Board-Folk/PC-Engine-Duo/cd_rom_control.kicad_sch

## KiCad design cd_rom_control.kicad_sch (2023-11-11)

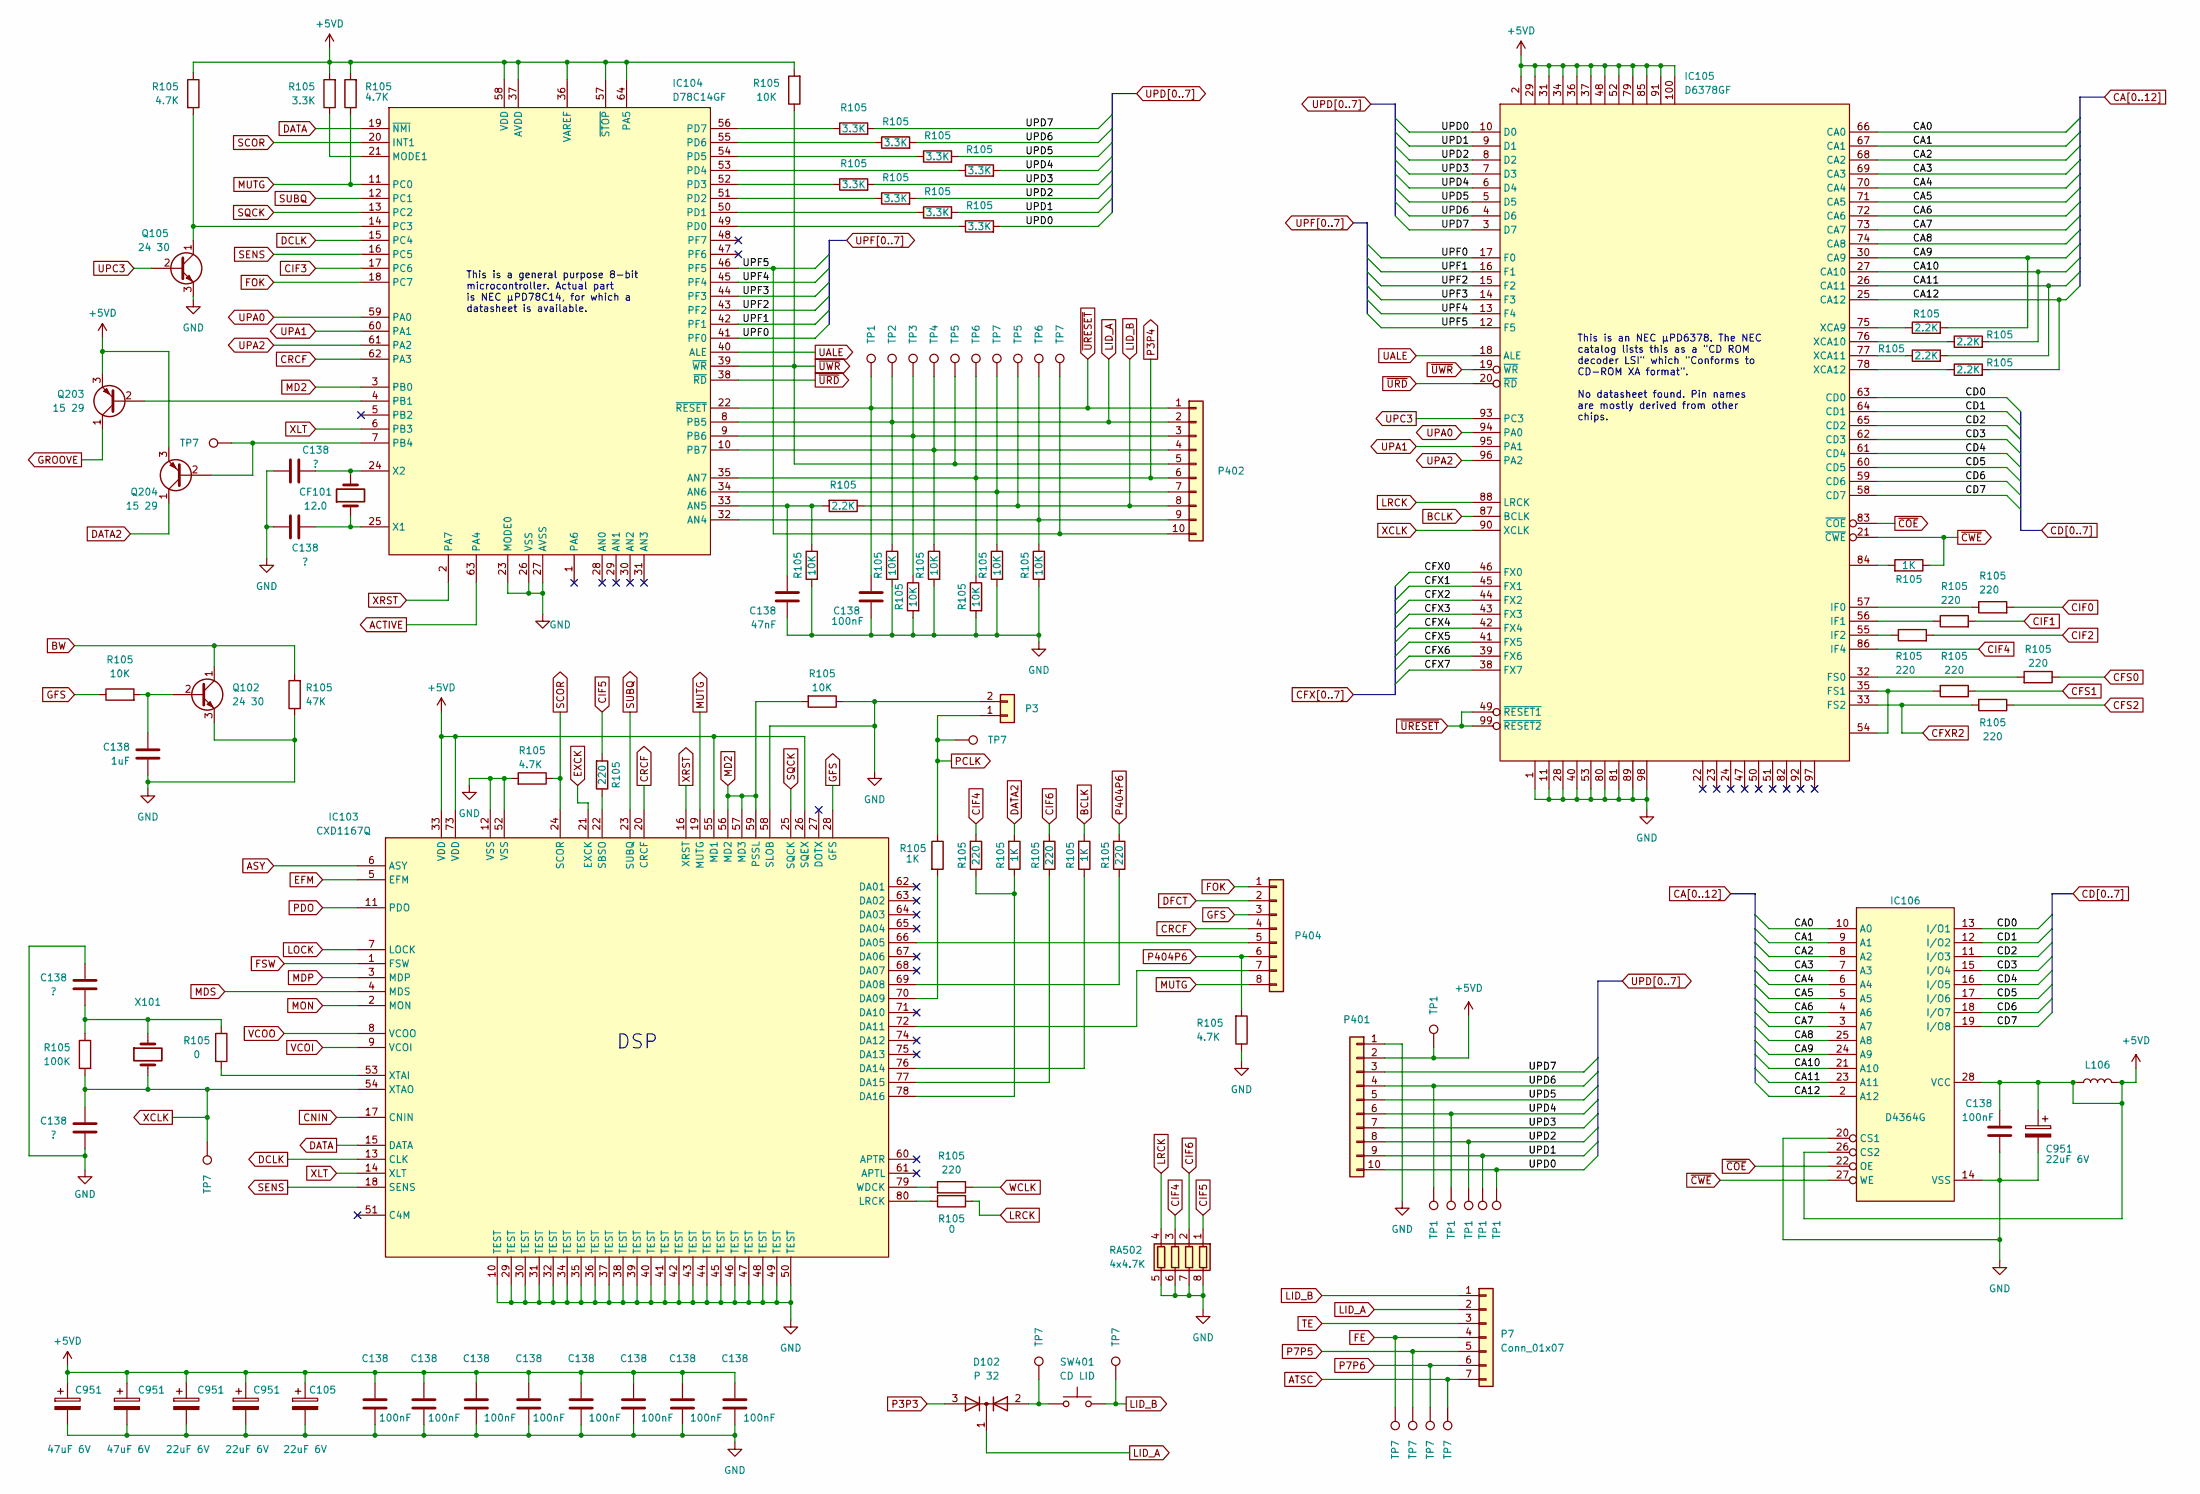
[picture p1: schematic cd_rom_control.kicad_sch]

Parts:
C105, C951: 22uF 6V; CP_6x1.5mm
C138: 100nF; SMD_0805_Narrow_Long
CF101: 12.0; CF_4.4x7.8
D102: P 32; Transistor_SMD
IC103: CXD1167Q; PQFP-80_P0.8mm
IC104: D78C14GF; QFP-64_19x13_Pitch1mm
IC105: D6378GF; PQFP-100_P0.65mm
IC106: D4364G; HSRM20256LM
L106: SMD_0805_Narrow
P3: Header_1x02_P2.00mm
P7: Conn_01x07; Header_1x07_P2.00mm
P401, P402: Header_1x10_P2.00mm
P404: Header_1x08_P2.00mm_Narrow
Q102, Q105: 24 30; Transistor_SMD
Q203, Q204: 15 29; Transistor_SMD
R105: 2.2K; SMD_0805_Narrow_Long
RA502: 4x4.7K; R_Array_4x0603
SW401: CD LID; SW_4Pin_3.25mm
TP1, TP2, TP3, TP4, TP5, TP6, TP7: Test_Point_1.5mm
X101: Crystal; L-5.00mm

Connections:
+5VD: C105.1, C138.1, C138.2, C951.1, IC103.26 (SQEX), IC103.33 (VDD), IC103.55 (MD1), IC103.73 (VDD), IC104.36 (VAREF), IC104.37 (AVDD), IC104.57 (~STOP), IC104.58 (VDD), IC104.64 (PA5), IC105.2, IC105.29, IC105.31, IC105.34, IC105.36, IC105.37, IC105.48, IC105.52, IC105.79, IC105.85, IC105.91, IC105.100, IC106.26 (CS2), IC106.28 (VCC), L106.1, L106.2, P401.2, Q203.3 (E), Q204.3 (E), R105.1, R105.2, TP1.1
ACTIVE: IC104.63 (PA4)
ASY: IC103.6 (ASY)
ATSC: P7.7, TP7.1
BCLK: IC105.87 (BCLK), R105.2
BW: Q102.1 (C), R105.2
CA0: IC105.66 (CA0), IC106.10 (A0)
CA1: IC105.67 (CA1), IC106.9 (A1)
CA2: IC105.68 (CA2), IC106.8 (A2)
CA3: IC105.69 (CA3), IC106.7 (A3)
CA4: IC105.70 (CA4), IC106.6 (A4)
CA5: IC105.71 (CA5), IC106.5 (A5)
CA6: IC105.72 (CA6), IC106.4 (A6)
CA7: IC105.73 (CA7), IC106.3 (A7)
CA8: IC105.74 (CA8), IC106.25 (A8)
CA9: IC105.30 (CA9), IC106.24 (A9), R105.2
CA10: IC105.27 (CA10), IC106.21 (A10), R105.2
CA11: IC105.26 (CA11), IC106.23 (A11), R105.2
CA12: IC105.25 (CA12), IC106.2 (A12), R105.2
CD0: IC105.63 (CD0), IC106.13 (I/O1)
CD1: IC105.64 (CD1), IC106.12 (I/O2)
CD2: IC105.65 (CD2), IC106.11 (I/O3)
CD3: IC105.62 (CD3), IC106.15 (I/O4)
CD4: IC105.61 (CD4), IC106.16 (I/O5)
CD5: IC105.60 (CD5), IC106.17 (I/O6)
CD6: IC105.59 (CD6), IC106.18 (I/O7)
CD7: IC105.58 (CD7), IC106.19 (I/O8)
CFS0: R105.1
CFS1: R105.1
CFS2: R105.1
CFX0: IC105.46 (FX0)
CFX1: IC105.45 (FX1)
CFX2: IC105.44 (FX2)
CFX3: IC105.43 (FX3)
CFX4: IC105.42 (FX4)
CFX5: IC105.41 (FX5)
CFX6: IC105.39 (FX6)
CFX7: IC105.38 (FX7)
CFXR2: IC105.33 (FS2), R105.2
CIF0: R105.2
CIF1: R105.2
CIF2: R105.2
CIF3: IC104.17 (PC6)
CIF4: IC105.86 (IF4), R105.2, RA502.3 (R3.1)
CIF5: R105.2, RA502.1 (R1.1)
CIF6: R105.2, RA502.2 (R2.1)
CNIN: IC103.17 (CNIN)
CRCF: IC103.20 (CRCF), IC104.62 (PA3), P404.4
DATA: IC103.15 (DATA), IC104.19 (~NMI)
DATA2: Q204.1 (C), R105.2
DCLK: IC103.13 (CLK), IC104.15 (PC4)
DFCT: P404.2
EFM: IC103.5 (EFM)
EXCK: IC103.21 (EXCK)
FE: P7.4, TP7.1
FOK: IC104.18 (PC7), P404.1
FSW: IC103.1 (FSW)
GFS: IC103.28 (GFS), P404.3, R105.1
GND: C105.2, C138.1, C138.2, C951.2, IC103.10 (TEST), IC103.12 (VSS), IC103.29 (TEST), IC103.30 (TEST), IC103.31 (TEST), IC103.32 (TEST), IC103.34 (TEST), IC103.35 (TEST), IC103.36 (TEST), IC103.37 (TEST), IC103.38 (TEST), IC103.39 (TEST), IC103.40 (TEST), IC103.41 (TEST), IC103.42 (TEST), IC103.43 (TEST), IC103.44 (TEST), IC103.45 (TEST), IC103.46 (TEST), IC103.47 (TEST), IC103.48 (TEST), IC103.49 (TEST), IC103.50 (TEST), IC103.52 (VSS), IC103.58 (SLOB), IC104.23 (MODE0), IC104.26 (VSS), IC104.27 (AVSS), IC105.1, IC105.11, IC105.28, IC105.40, IC105.53, IC105.80, IC105.81, IC105.89, IC105.98, IC106.14 (VSS), IC106.20 (CS1), P3.2, P401.1, Q102.3 (E), Q105.3 (E), R105.1, R105.2, RA502.5 (R4.2), RA502.6 (R3.2), RA502.7 (R2.2), RA502.8 (R1.2)
GROOVE: Q203.1 (C)
LID_A: D102.1 (K), IC104.8 (PB5), P7.2, P402.2, R105.1, TP2.1
LID_B: P7.1, P402.8, R105.1, SW401.2, TP5.1, TP7.1
LOCK: IC103.7 (LOCK)
LRCK: IC105.88 (LRCK), R105.2, RA502.4 (R4.1)
MD2: IC103.56 (MD2), IC103.57 (MD3), IC103.59 (PSSL), IC104.3 (PB0), R105.2
MDP: IC103.3 (MDP)
MDS: IC103.4 (MDS)
MON: IC103.2 (MON)
MUTG: IC103.19 (MUTG), IC104.11 (PC0), P404.8, R105.1
unnamed: C138.1, CF101.1, CF101.2, IC104.24 (X2), IC104.25 (X1), Q102.2 (B), R105.2
unnamed: C138.2, IC104.33 (AN5), R105.1, R105.2, X101.1
unnamed: D102.2 (A), SW401.1, TP7.1
unnamed: IC103.22 (SBSO), R105.1
unnamed: IC103.53 (XTAI), R105.2
unnamed: IC103.66 (DA05), P404.5
unnamed: IC103.69 (DA08), R105.1
unnamed: IC103.70 (DA09), R105.2
unnamed: IC103.72 (DA11), P404.7
unnamed: IC103.76 (DA14), R105.1
unnamed: IC103.77 (DA15), R105.1
unnamed: IC103.78 (DA16), R105.1
unnamed: IC103.79 (WDCK), R105.2
unnamed: IC103.80 (LRCK), R105.1
unnamed: IC104.4 (PB1), Q203.2 (B)
unnamed: IC104.7 (PB4), Q204.2 (B), TP7.1
unnamed: IC104.9 (PB6), P402.3, R105.1, TP3.1
unnamed: IC104.10 (PB7), P402.4, R105.1, TP4.1
unnamed: IC104.14 (PC3), Q105.1 (C), R105.2
unnamed: IC104.21 (MODE1), R105.1
unnamed: IC104.32 (AN4), P402.9, R105.1, TP6.1
unnamed: IC104.34 (AN6), P402.7, R105.1, TP7.1
unnamed: IC104.49 (PD0), R105.1
unnamed: IC104.50 (PD1), R105.1
unnamed: IC104.51 (PD2), R105.1
unnamed: IC104.52 (PD3), R105.1
unnamed: IC104.53 (PD4), R105.1
unnamed: IC104.54 (PD5), R105.1
unnamed: IC104.55 (PD6), R105.1
unnamed: IC104.56 (PD7), R105.1
unnamed: IC105.32 (FS0), R105.2
unnamed: IC105.35 (FS1), IC105.54, R105.2
unnamed: IC105.55 (IF2), R105.1
unnamed: IC105.56 (IF1), R105.1
unnamed: IC105.57 (IF0), R105.1
unnamed: IC105.75 (XCA9), R105.1
unnamed: IC105.76 (XCA10), R105.1
unnamed: IC105.77 (XCA11), R105.1
unnamed: IC105.78 (XCA12), R105.1
unnamed: IC105.84, R105.2
P3P3: D102.3 (A)
P3P4: IC104.35 (AN7), P402.6, R105.1, TP6.1
P7P5: P7.5, TP7.1
P7P6: P7.6, TP7.1
P404P6: P404.6, R105.2
PCLK: P3.1, R105.1, TP7.1
PDO: IC103.11 (PDO)
SCOR: IC103.24 (SCOR), IC104.20 (INT1), R105.1
SENS: IC103.18 (SENS), IC104.16 (PC5)
SQCK: IC103.25 (SQCK), IC104.13 (PC2)
SUBQ: IC103.23 (SUBQ), IC104.12 (PC1)
TE: P7.3
UALE: IC104.40 (ALE), IC105.18 (ALE)
UPA0: IC104.59 (PA0), IC105.94 (PA0)
UPA1: IC104.60 (PA1), IC105.95 (PA1)
UPA2: IC104.61 (PA2), IC105.96 (PA2)
UPC3: IC105.93 (PC3), Q105.2 (B)
UPD0: IC105.10 (D0), P401.10, R105.2, TP1.1
UPD1: IC105.9 (D1), P401.9, R105.2, TP1.1
UPD2: IC105.8 (D2), P401.8, R105.2, TP1.1
UPD3: IC105.7 (D3), P401.7, R105.2
UPD4: IC105.6 (D4), P401.6, R105.2, TP1.1
UPD5: IC105.5 (D5), P401.5, R105.2
UPD6: IC105.4 (D6), P401.4, R105.2, TP1.1
UPD7: IC105.3 (D7), P401.3, R105.2
UPF0: IC104.41 (PF0), IC105.17 (F0)
UPF1: IC104.42 (PF1), IC105.16 (F1)
UPF2: IC104.43 (PF2), IC105.15 (F2)
UPF3: IC104.44 (PF3), IC105.14 (F3)
UPF4: IC104.45 (PF4), IC105.13 (F4)
UPF5: IC104.46 (PF5), IC105.12 (F5), P402.10, TP7.1
VCOI: IC103.9 (VCOI)
VCOO: IC103.8 (VCOO)
WCLK: R105.1
XCLK: C138.2, IC103.54 (XTAO), IC105.90 (XCLK), R105.2, TP7.1, X101.2
XLT: IC103.14 (XLT), IC104.6 (PB3)
XRST: IC103.16 (XRST), IC104.2 (PA7)
~COE: IC105.83 (~COE), IC106.22 (OE)
~CWE: IC105.21 (~CWE), IC106.27 (WE), R105.1
~URD: IC104.38 (~RD), IC105.20 (~RD)
~URESET: C138.1, IC104.22 (~RESET), IC105.49 (~RESET1), IC105.99 (~RESET2), P402.1, TP1.1
~UWR: IC104.39 (~WR), IC105.19 (~WR), P402.5, R105.1, TP5.1

Notes on the sheet:
This is an NEC μPD6378. The NEC catalog lists this as a "CD ROM decoder LSI" which "Conforms to CD-ROM XA format". No datasheet found. Pin names are mostly derived from other chips.
This is a general purpose 8-bit microcontroller. Actual part is NEC μPD78C14, for which a datasheet is available.
DSP
