Board-Folk/PC-Engine-Duo/cd_rom_mech.kicad_sch

## KiCad design cd_rom_mech.kicad_sch (2023-11-13)

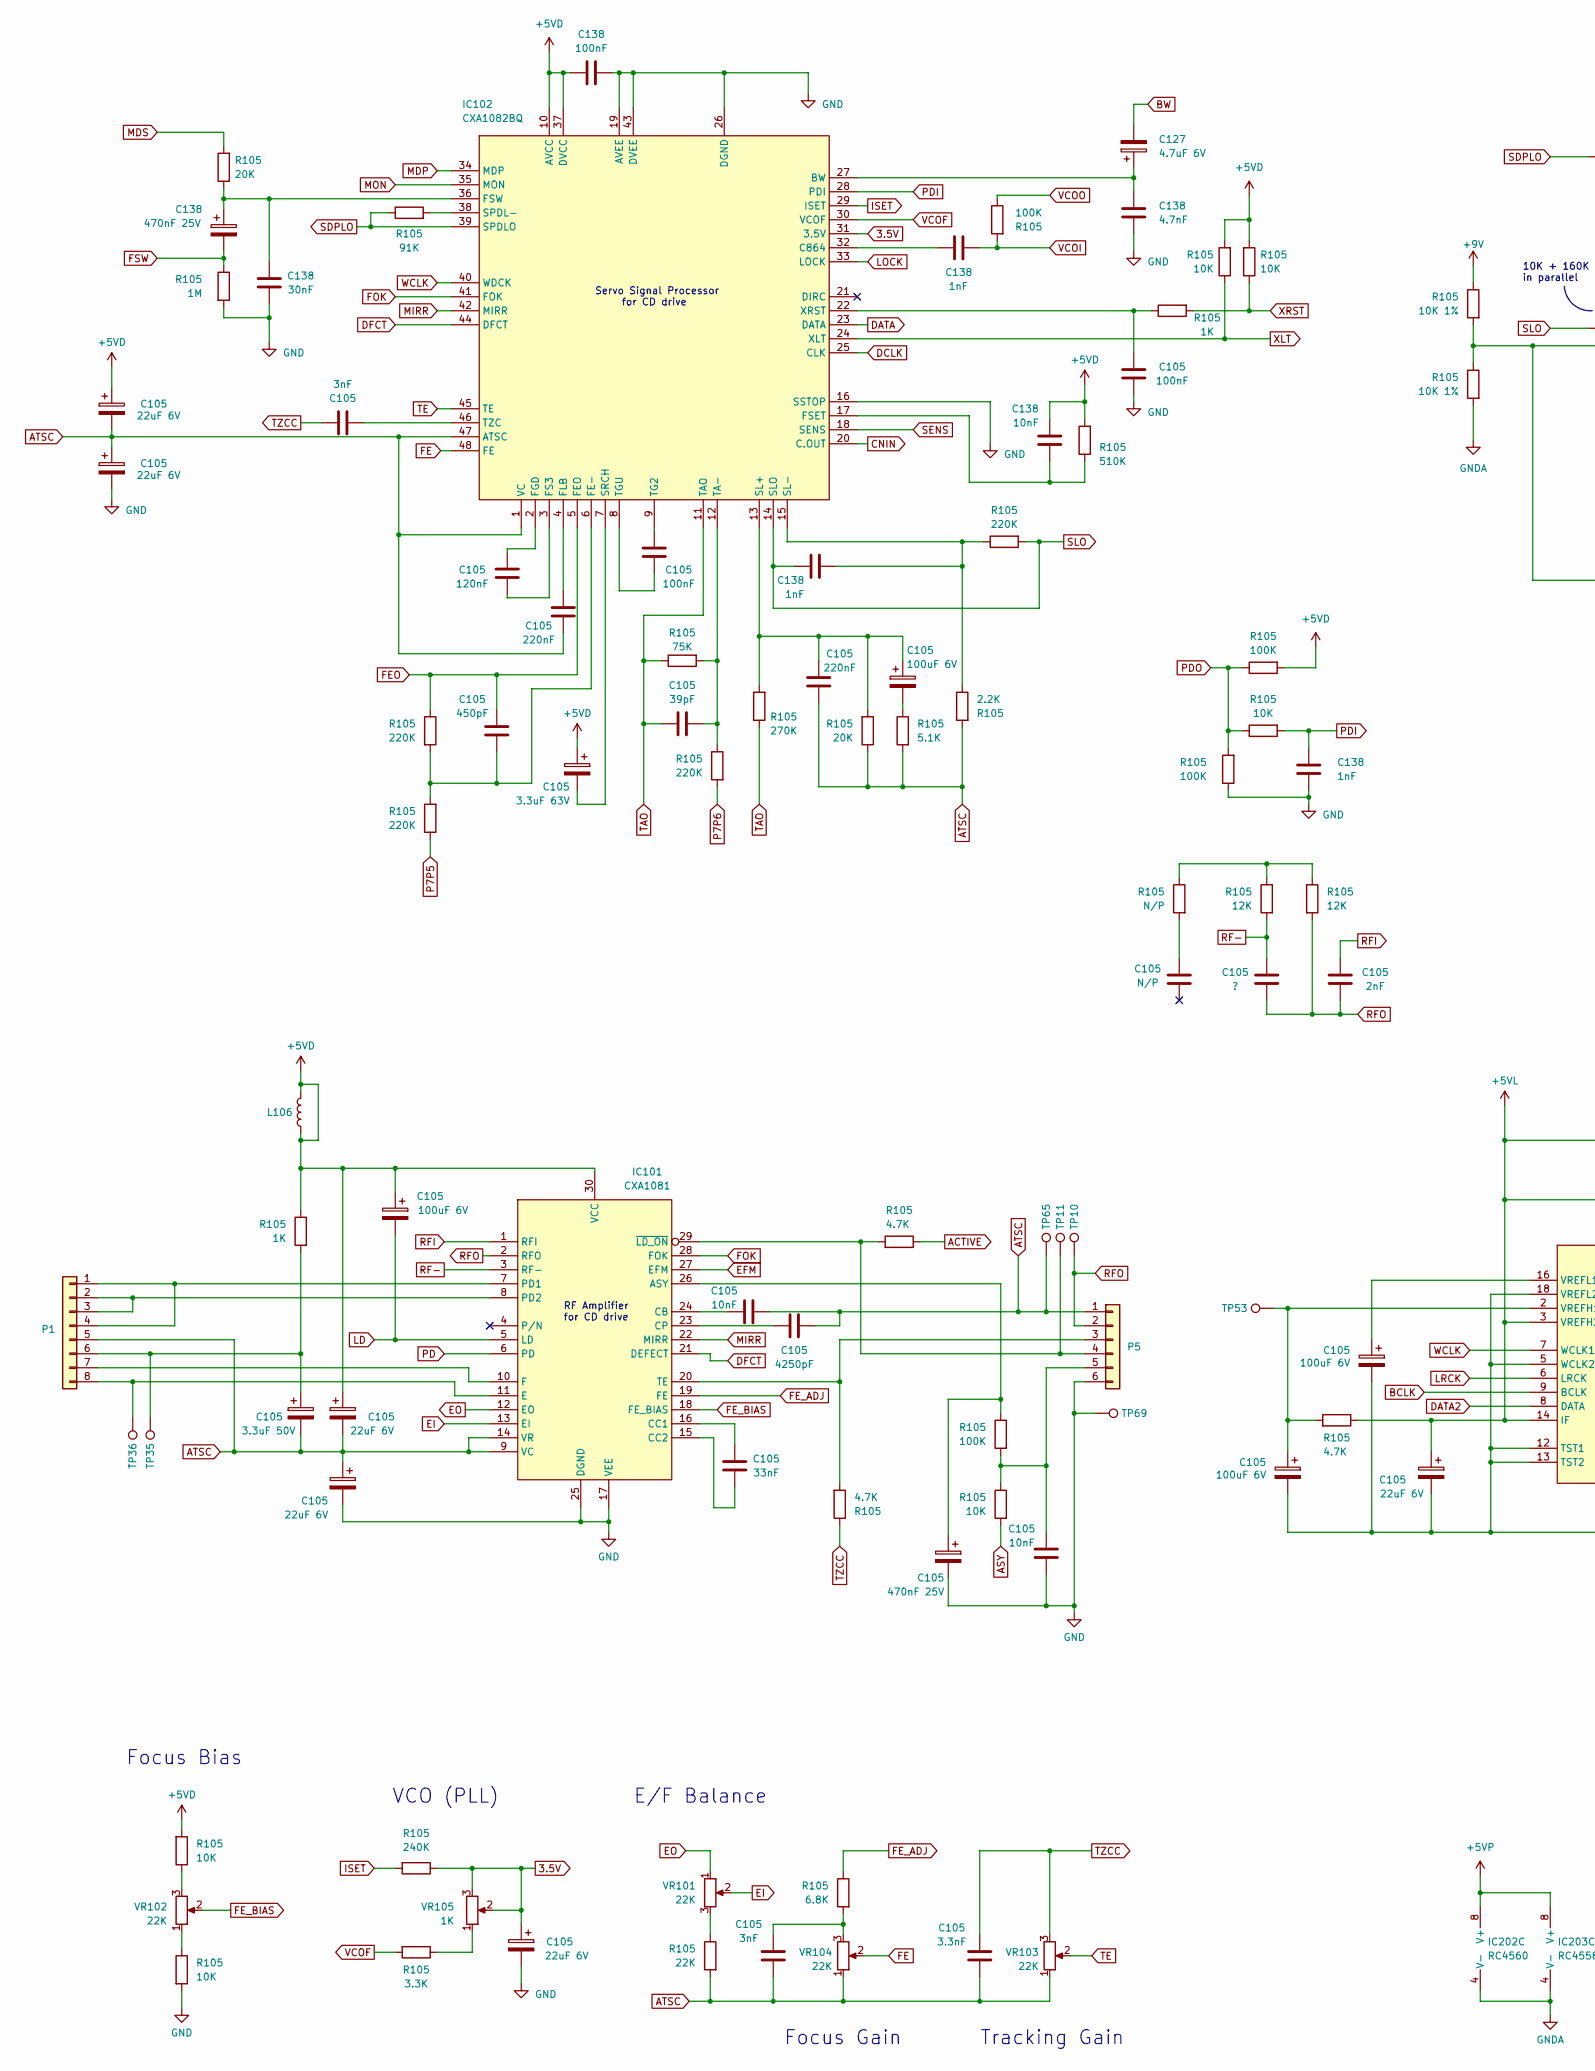
[picture p2: schematic cd_rom_mech.kicad_sch, part in row 1, column 1]

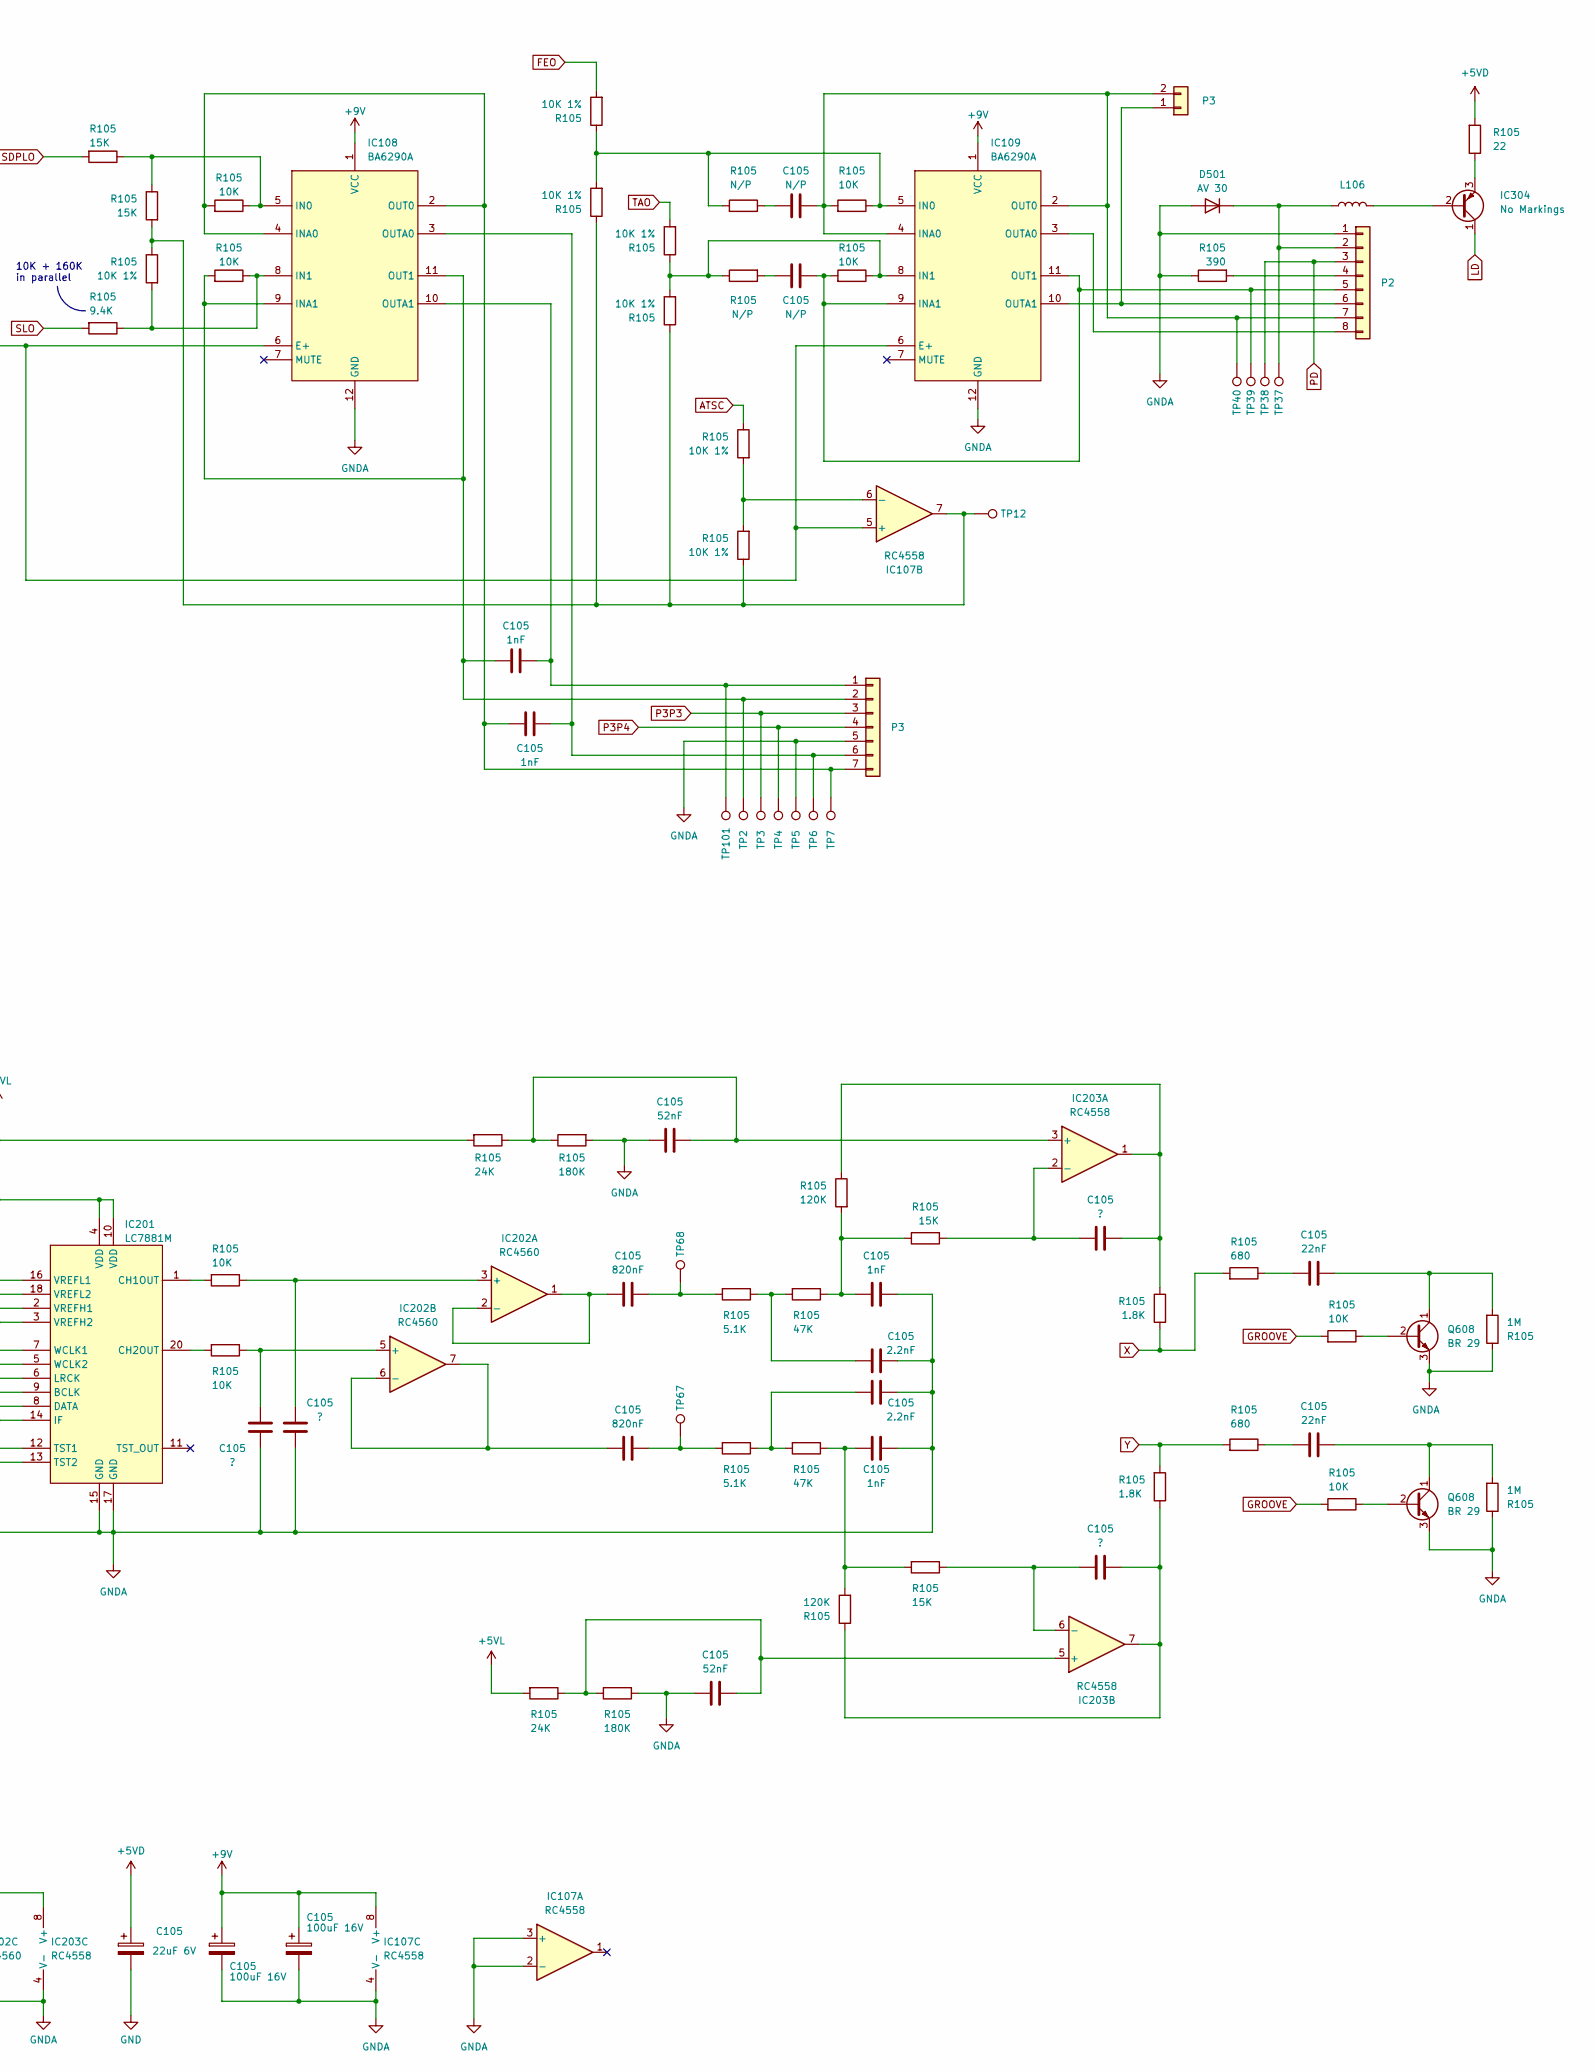
[picture p3: schematic cd_rom_mech.kicad_sch, part in row 1, column 2]

Parts:
C105: ?; SMD_0805_Narrow_Long
C127: 4.7uF 6V; CP_1806
C138: 470nF 25V; CP_1206
D501: AV 30; Transistor_SMD
IC101: CXA1081; SSOP-30_P1.27mm
IC102: CXA1082BQ; QFP-48_14x14_Pitch0.8mm
IC107, IC203: RC4558; SO-8_P1.27mm
IC108, IC109: BA6290A; SIL-12_P2.54mm
IC201: LC7881M; SO-20_P1.27mm_Gutters
IC202: RC4560; SO-8_P1.27mm
IC304: No Markings; SOT-89-3
L106: SMD_1210
P1, P2: Header_1x08_P2.00mm
P3: Header_1x02_P2.00mm
P5: Header_1x06_P2.00mm
Q608: BR 29; Transistor_SMD
R105: 10K; SMD_0805_Narrow
TP2, TP3, TP4, TP5, TP6, TP7, TP10, TP11, TP12, TP35, TP36, TP37, TP38, TP39, TP40, TP53, TP65, TP69, TP101: Test_Point_1.5mm
TP67, TP68: Test_Point_1.5mm_THT_NoSilk
VR101, VR102, VR103, VR104: 22K; Duo_VR
VR105: 1K; Duo_VR

Connections:
3.5V: C105.1, IC102.31 (3.5V), R105.1, VR105.2, VR105.3
+5VD: C105.1, C138.2, IC101.30 (VCC), IC102.10 (AVCC), IC102.37 (DVCC), L106.1, L106.2, R105.1, R105.2
+5VL: C105.1, IC201.3 (VREFH2), IC201.4 (VDD), IC201.10 (VDD), IC201.14 (IF), R105.1, R105.2
+5VP: IC202.8 (V+), IC203.8 (V+)
+9V: C105.1, IC107.8 (V+), IC108.1 (VCC), IC109.1 (VCC), R105.1
ACTIVE: R105.1
ASY: R105.2
ATSC: C105.1, C105.2, IC101.9 (VC), IC101.14 (VR), IC102.1 (VC), IC102.47 (ATSC), P1.5, P5.1, R105.1, R105.2, TP65.1, VR103.1, VR104.1
BCLK: IC201.9 (BCLK)
BW: C127.2
CNIN: IC102.20 (C.OUT)
DATA: IC102.23 (DATA)
DATA2: IC201.8 (DATA)
DCLK: IC102.25 (CLK)
DFCT: IC101.21 (DEFECT), IC102.44 (DFCT)
EFM: IC101.27 (EFM)
EI: IC101.13 (EI), VR101.2
EO: IC101.12 (EO), VR101.1
FE: IC102.48 (FE), VR104.2
FEO: C105.1, IC102.5 (FEO), R105.1, R105.2
FE_ADJ: IC101.19 (FE), R105.1
FE_BIAS: IC101.18 (FE_BIAS), VR102.2
FOK: IC101.28 (FOK), IC102.41 (FOK)
FSW: C138.2, R105.1
GND: C105.2, C138.1, C138.2, IC101.17 (VEE), IC101.25 (DGND), IC102.16 (SSTOP), IC102.19 (AVEE), IC102.26 (DGND), IC102.43 (DVEE), P5.6, R105.1, R105.2, TP69.1
GNDA: C105.1, C105.2, D501.2 (A), IC107.2 (-), IC107.3 (+), IC107.4 (V-), IC108.12 (GND), IC109.12 (GND), IC201.5 (WCLK2), IC201.12 (TST1), IC201.13 (TST2), IC201.15 (GND), IC201.17 (GND), IC201.18 (VREFL2), IC202.4 (V-), IC203.4 (V-), P2.1, P3.5, Q608.3 (E), R105.1, R105.2, TP5.1
GROOVE: R105.2
ISET: IC102.29 (ISET), R105.2
LD: C105.2, IC101.5 (LD), IC304.1 (C)
LOCK: IC102.33 (LOCK)
LRCK: IC201.6 (LRCK)
MDP: IC102.34 (MDP)
MDS: R105.2
MIRR: IC101.22 (MIRR), IC102.42 (MIRR)
MON: IC102.35 (MON)
unnamed: C105.1, C105.2, IC101.16 (CC1), IC101.26 (ASY), IC102.3 (FS3), IC102.8 (TGU), IC102.13 (SL+), IC102.22 (XRST), IC102.46 (TZC), IC108.3 (OUTA0), IC108.10 (OUTA1), IC109.2 (OUT0), IC109.4 (INA0), IC201.2 (VREFH1), IC201.16 (VREFL1), IC203.1, IC203.7, P1.6, P2.7, P3.1, P3.2, P3.6, P5.5, Q608.1 (C), R105.1, R105.2, TP6.1, TP35.1, TP40.1, TP53.1, TP67.1, TP68.1, TP101.1, VR104.3
unnamed: C105.2, IC101.15 (CC2), IC101.23 (CP), IC101.24 (CB), IC102.2 (FGD), IC102.4 (FLB), IC102.6 (FE-), IC102.7 (SRCH), IC102.9 (TG2), IC102.12 (TA-), IC108.2 (OUT0), IC108.4 (INA0), IC108.9 (INA1), IC108.11 (OUT1), IC109.9 (INA1), IC109.11 (OUT1), IC202.1, IC202.2 (-), IC202.3 (+), IC202.5 (+), IC202.6 (-), IC202.7, IC203.2 (-), IC203.3 (+), IC203.5 (+), IC203.6 (-), P2.5, P3.2, P3.7, R105.1, R105.2, TP2.1, TP7.1, TP39.1
unnamed: C127.1, C138.2, IC102.27 (BW)
unnamed: C138.1, C138.2, IC102.17 (FSET), IC102.36 (FSW), R105.1
unnamed: C138.2, IC102.15 (SL-), IC102.32 (C864), R105.1
unnamed: D501.1 (K), L106.2, P2.2, TP37.1
unnamed: IC101.7 (PD1), P1.1, P1.4
unnamed: IC101.8 (PD2), P1.2, P1.3
unnamed: IC101.10 (F), P1.7
unnamed: IC101.11 (E), P1.8, TP36.1
unnamed: IC101.20 (TE), P5.3, R105.2
unnamed: IC101.29 (~LD_ON), P5.4, R105.2, TP11.1
unnamed: IC102.38 (SPDL-), R105.2
unnamed: IC107.5 (+), IC108.6 (E+), IC109.6 (E+), R105.1, R105.2
unnamed: IC107.6 (-), R105.2
unnamed: IC107.7, R105.1, R105.2, TP12.1
unnamed: IC108.5 (IN0), R105.1
unnamed: IC108.8 (IN1), R105.1, R105.2
unnamed: IC109.3 (OUTA0), P2.8
unnamed: IC109.5 (IN0), R105.1, R105.2
unnamed: IC109.8 (IN1), R105.1, R105.2
unnamed: IC109.10 (OUTA1), P2.6, P3.1
unnamed: IC201.1 (CH1OUT), R105.2
unnamed: IC201.20 (CH2OUT), R105.2
unnamed: IC304.2 (B), L106.1
unnamed: IC304.3 (E), R105.1
unnamed: P2.4, R105.2
unnamed: Q608.2 (B), R105.1
unnamed: R105.1, VR101.3, VR102.1, VR102.3, VR105.1
P3P3: P3.3, TP3.1
P3P4: P3.4, TP4.1
P7P5: R105.1
P7P6: R105.2
PD: IC101.6 (PD), P2.3, TP38.1
PDI: C138.1, IC102.28 (PDI), R105.2
PDO: R105.1, R105.2
RF-: C105.1, IC101.3 (RF-), R105.2
RFI: C105.1, IC101.1 (RFI)
RFO: C105.2, IC101.2 (RFO), P5.2, R105.2, TP10.1
SDPLO: IC102.39 (SPDLO), R105.1, R105.2
SENS: IC102.18 (SENS)
SLO: C138.1, IC102.14 (SLO), R105.2
TAO: C105.1, IC102.11 (TAO), R105.1, R105.2
TE: IC102.45 (TE), VR103.2
TZCC: C105.2, R105.1, VR103.3
VCOF: IC102.30 (VCOF), R105.2
VCOI: C138.1, R105.2
VCOO: R105.1
WCLK: IC102.40 (WDCK), IC201.7 (WCLK1)
X: R105.2
XLT: IC102.24 (XLT), R105.1
XRST: R105.1, R105.2
Y: R105.2

Notes on the sheet:
E/F Balance
Focus Gain
10K + 160K in parallel
Focus Bias
Tracking Gain
Servo Signal Processor for CD drive
RF Amplifier for CD drive
VCO (PLL)
