Board-Folk/PC-Engine-Duo/connectors.kicad_sch

## KiCad design connectors.kicad_sch (2023-11-13)

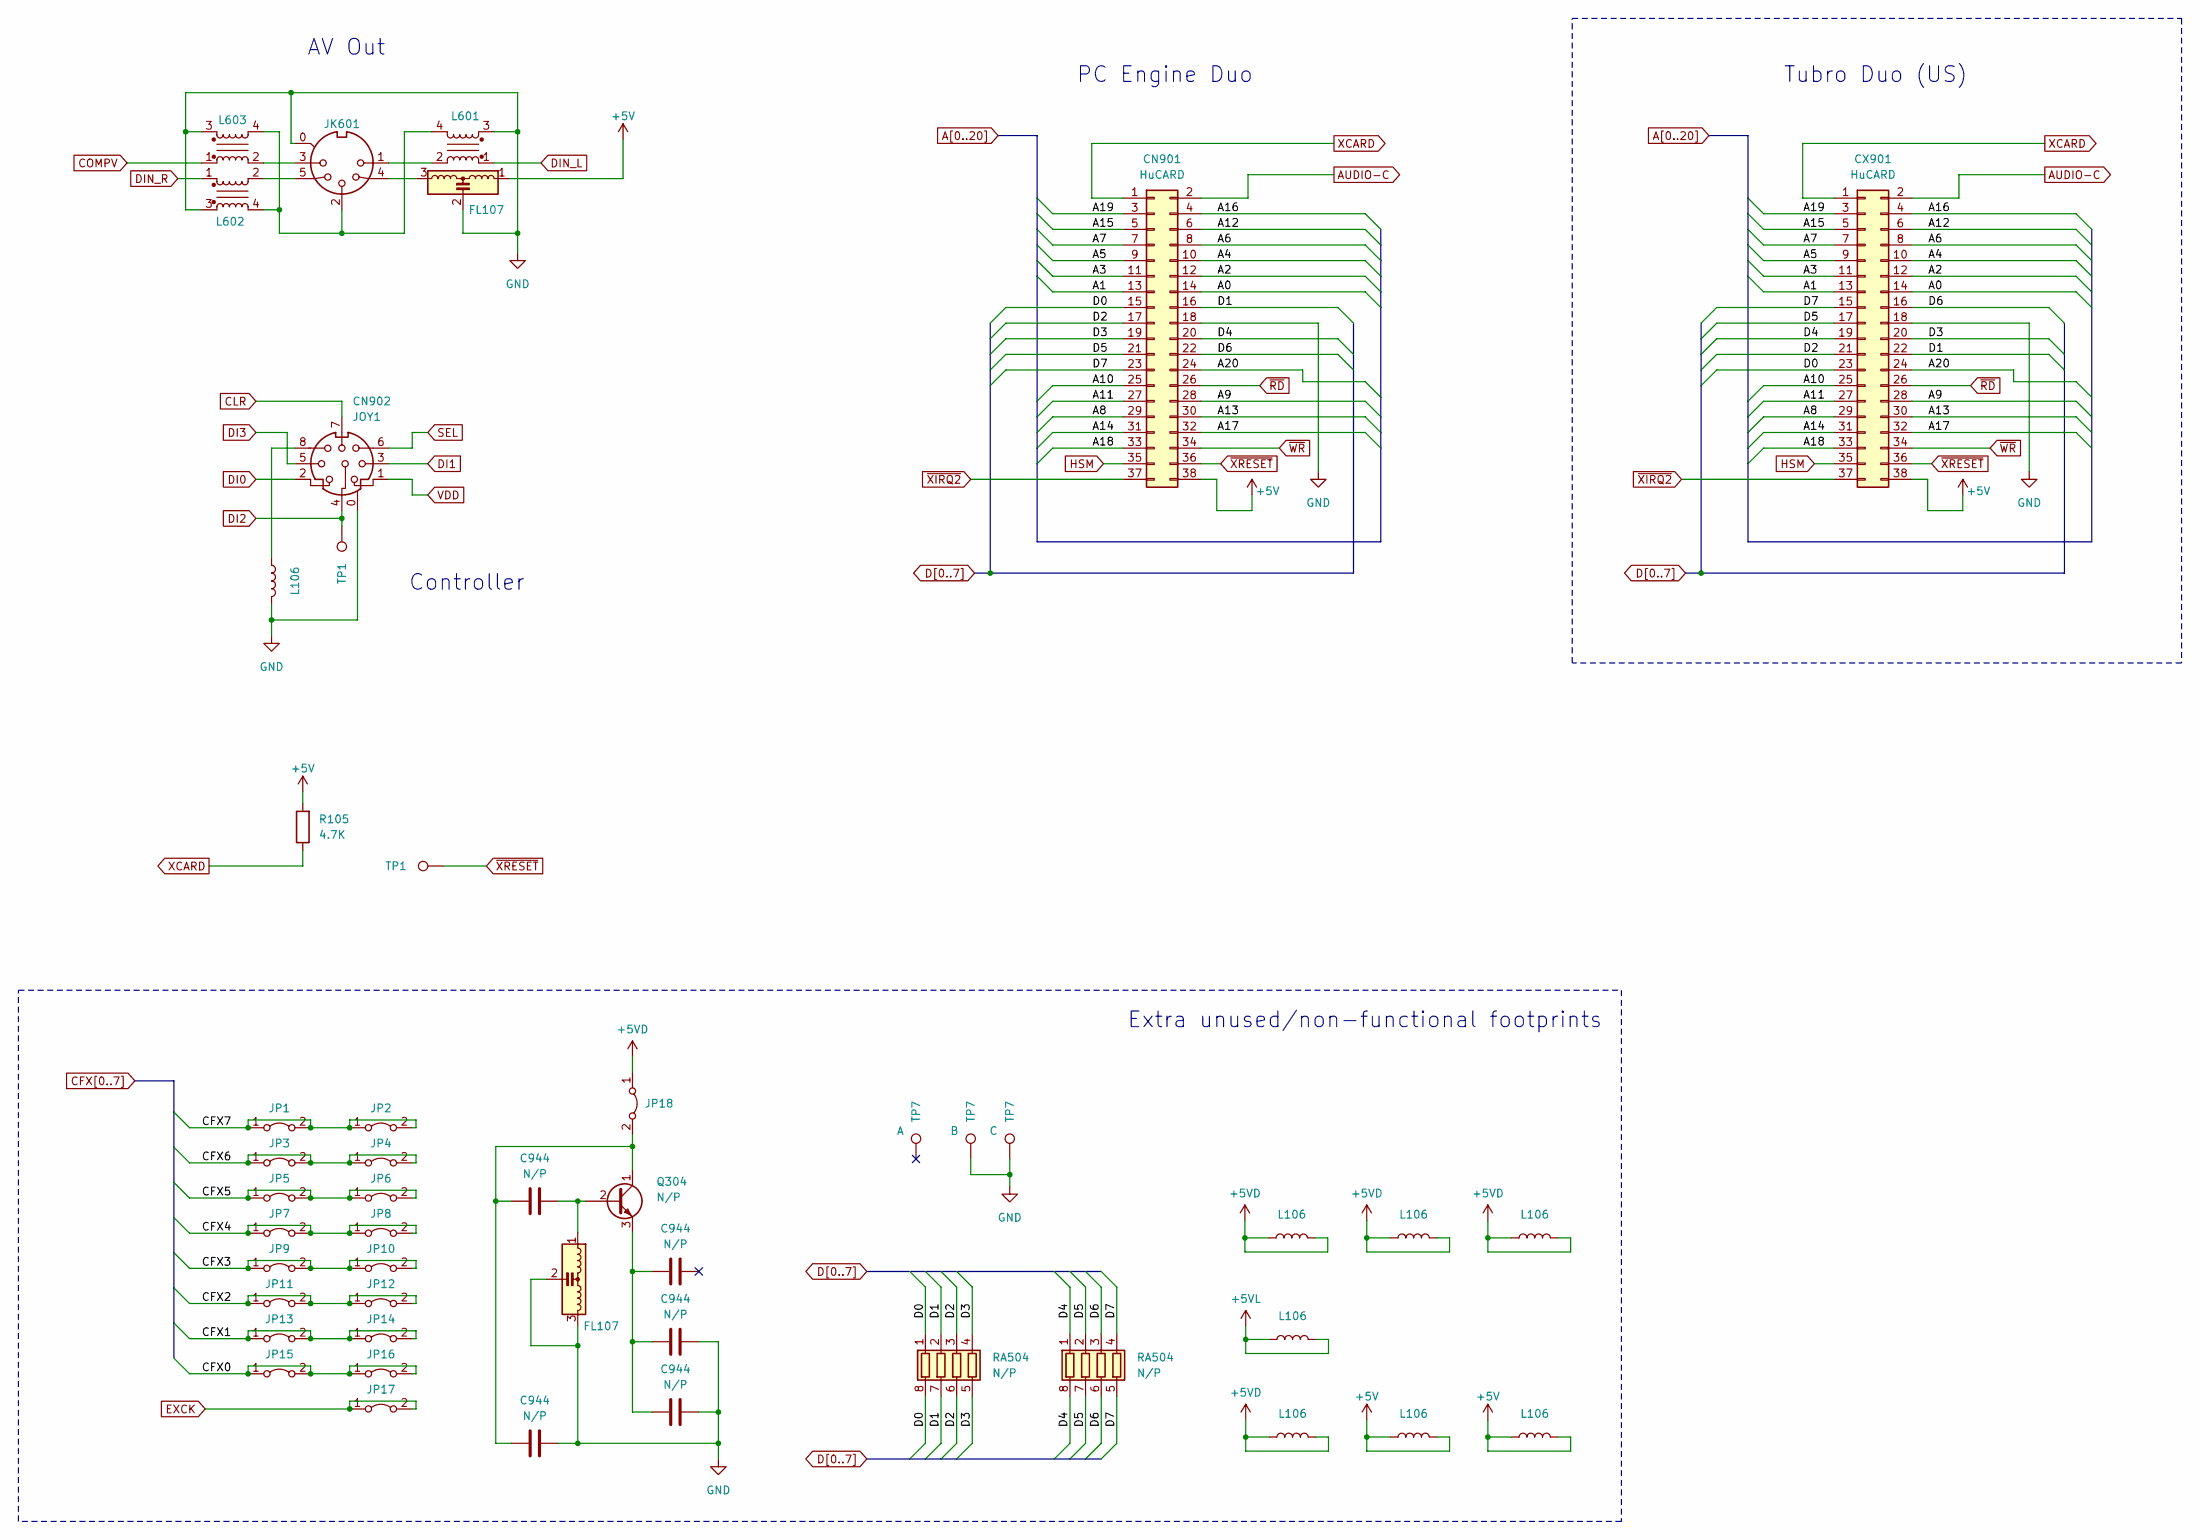
[picture p4: schematic connectors.kicad_sch]

Parts:
C944: N/P; SMD_0805_Narrow_NoSilk
CN901: HuCARD; Duo_HuCard
CN902: JOY1; Mini-DIN-8
CX901: HuCARD; Duo_HuCard
FL107: Filter_EMI_LCL; FL-5.00mm
JK601: DIN-5_180degree; DIN-5
JP1, JP3, JP5, JP7, JP9, JP11, JP13, JP15: SMD_0805_Narrow_NoSilk
JP2, JP4, JP6, JP8, JP10, JP12, JP14, JP16, JP17, JP18: SMD_1206_C_NoSilk
L106: L-5.00mm
L601, L602, L603: EMI_Dual_small
Q304: N/P; Transistor_SMD_NoSilk
R105: 4.7K; SMD_0805_Narrow_Long
RA504: N/P; R_Array_4x0603
TP1: Test_Point_1.5mm
TP7: B; Test_Point_2mm_THT

Connections:
+5V: CN901.38, CX901.38, FL107.1, L106.1, L106.2, R105.2
+5VD: JP18.1 (A), L106.1, L106.2
+5VL: L106.1, L106.2
A0: CN901.14, CX901.14
A1: CN901.13, CX901.13
A2: CN901.12, CX901.12
A3: CN901.11, CX901.11
A4: CN901.10, CX901.10
A5: CN901.9, CX901.9
A6: CN901.8, CX901.8
A7: CN901.7, CX901.7
A8: CN901.29, CX901.29
A9: CN901.28, CX901.28
A10: CN901.25, CX901.25
A11: CN901.27, CX901.27
A12: CN901.6, CX901.6
A13: CN901.30, CX901.30
A14: CN901.31, CX901.31
A15: CN901.5, CX901.5
A16: CN901.4, CX901.4
A17: CN901.32, CX901.32
A18: CN901.33, CX901.33
A19: CN901.3, CX901.3
A20: CN901.24, CX901.24
AUDIO-C: CN901.2, CX901.2
CFX0: JP15.1 (A), JP15.2 (B), JP16.1 (A), JP16.2 (B)
CFX1: JP13.1 (A), JP13.2 (B), JP14.1 (A), JP14.2 (B)
CFX2: JP11.1 (A), JP11.2 (B), JP12.1 (A), JP12.2 (B)
CFX3: JP9.1 (A), JP9.2 (B), JP10.1 (A), JP10.2 (B)
CFX4: JP7.1 (A), JP7.2 (B), JP8.1 (A), JP8.2 (B)
CFX5: JP5.1 (A), JP5.2 (B), JP6.1 (A), JP6.2 (B)
CFX6: JP3.1 (A), JP3.2 (B), JP4.1 (A), JP4.2 (B)
CFX7: JP1.1 (A), JP1.2 (B), JP2.1 (A), JP2.2 (B)
CLR: CN902.7
COMPV: L603.1
D0: CN901.15, CX901.23, RA504.1 (R1.1), RA504.8 (R1.2)
D1: CN901.16, CX901.22, RA504.2 (R2.1), RA504.7 (R2.2)
D2: CN901.17, CX901.21, RA504.3 (R3.1), RA504.6 (R3.2)
D3: CN901.19, CX901.20, RA504.4 (R4.1), RA504.5 (R4.2)
D4: CN901.20, CX901.19, RA504.1 (R1.1), RA504.8 (R1.2)
D5: CN901.21, CX901.17, RA504.2 (R2.1), RA504.7 (R2.2)
D6: CN901.22, CX901.16, RA504.3 (R3.1), RA504.6 (R3.2)
D7: CN901.23, CX901.15, RA504.4 (R4.1), RA504.5 (R4.2)
DI0: CN902.2
DI1: CN902.3
DI2: CN902.4, TP1.1
DI3: CN902.5
DIN_L: L601.1
DIN_R: L602.1
EXCK: JP17.1 (A), JP17.2 (B)
GND: C944.2, CN901.18, CN902.0, CX901.18, FL107.2, FL107.3, JK601.0, L106.2, L601.3, L602.3, L603.3, TP7.1
HSM: CN901.35, CX901.35
unnamed: C944.1, JP18.2 (B), Q304.1 (C), Q304.3 (E)
unnamed: C944.2, FL107.1, Q304.2 (B)
unnamed: CN902.8, L106.1
unnamed: FL107.3, JK601.4
unnamed: JK601.1, L601.2
unnamed: JK601.2, L601.4, L602.4, L603.4
unnamed: JK601.3, L603.2
unnamed: JK601.5, L602.2
SEL: CN902.6
VDD: CN902.1
XCARD: CN901.1, CX901.1, R105.1
~RD: CN901.26, CX901.26
~WR: CN901.34, CX901.34
~XIRQ2: CN901.37, CX901.37
~XRESET: CN901.36, CX901.36, TP1.1

Notes on the sheet:
Tubro Duo (US)
Controller
Extra unused/non-functional footprints
PC Engine Duo
AV Out
