Board-Folk/PC-Engine-Duo/cpu.kicad_sch

## KiCad design cpu.kicad_sch (2023-11-11)

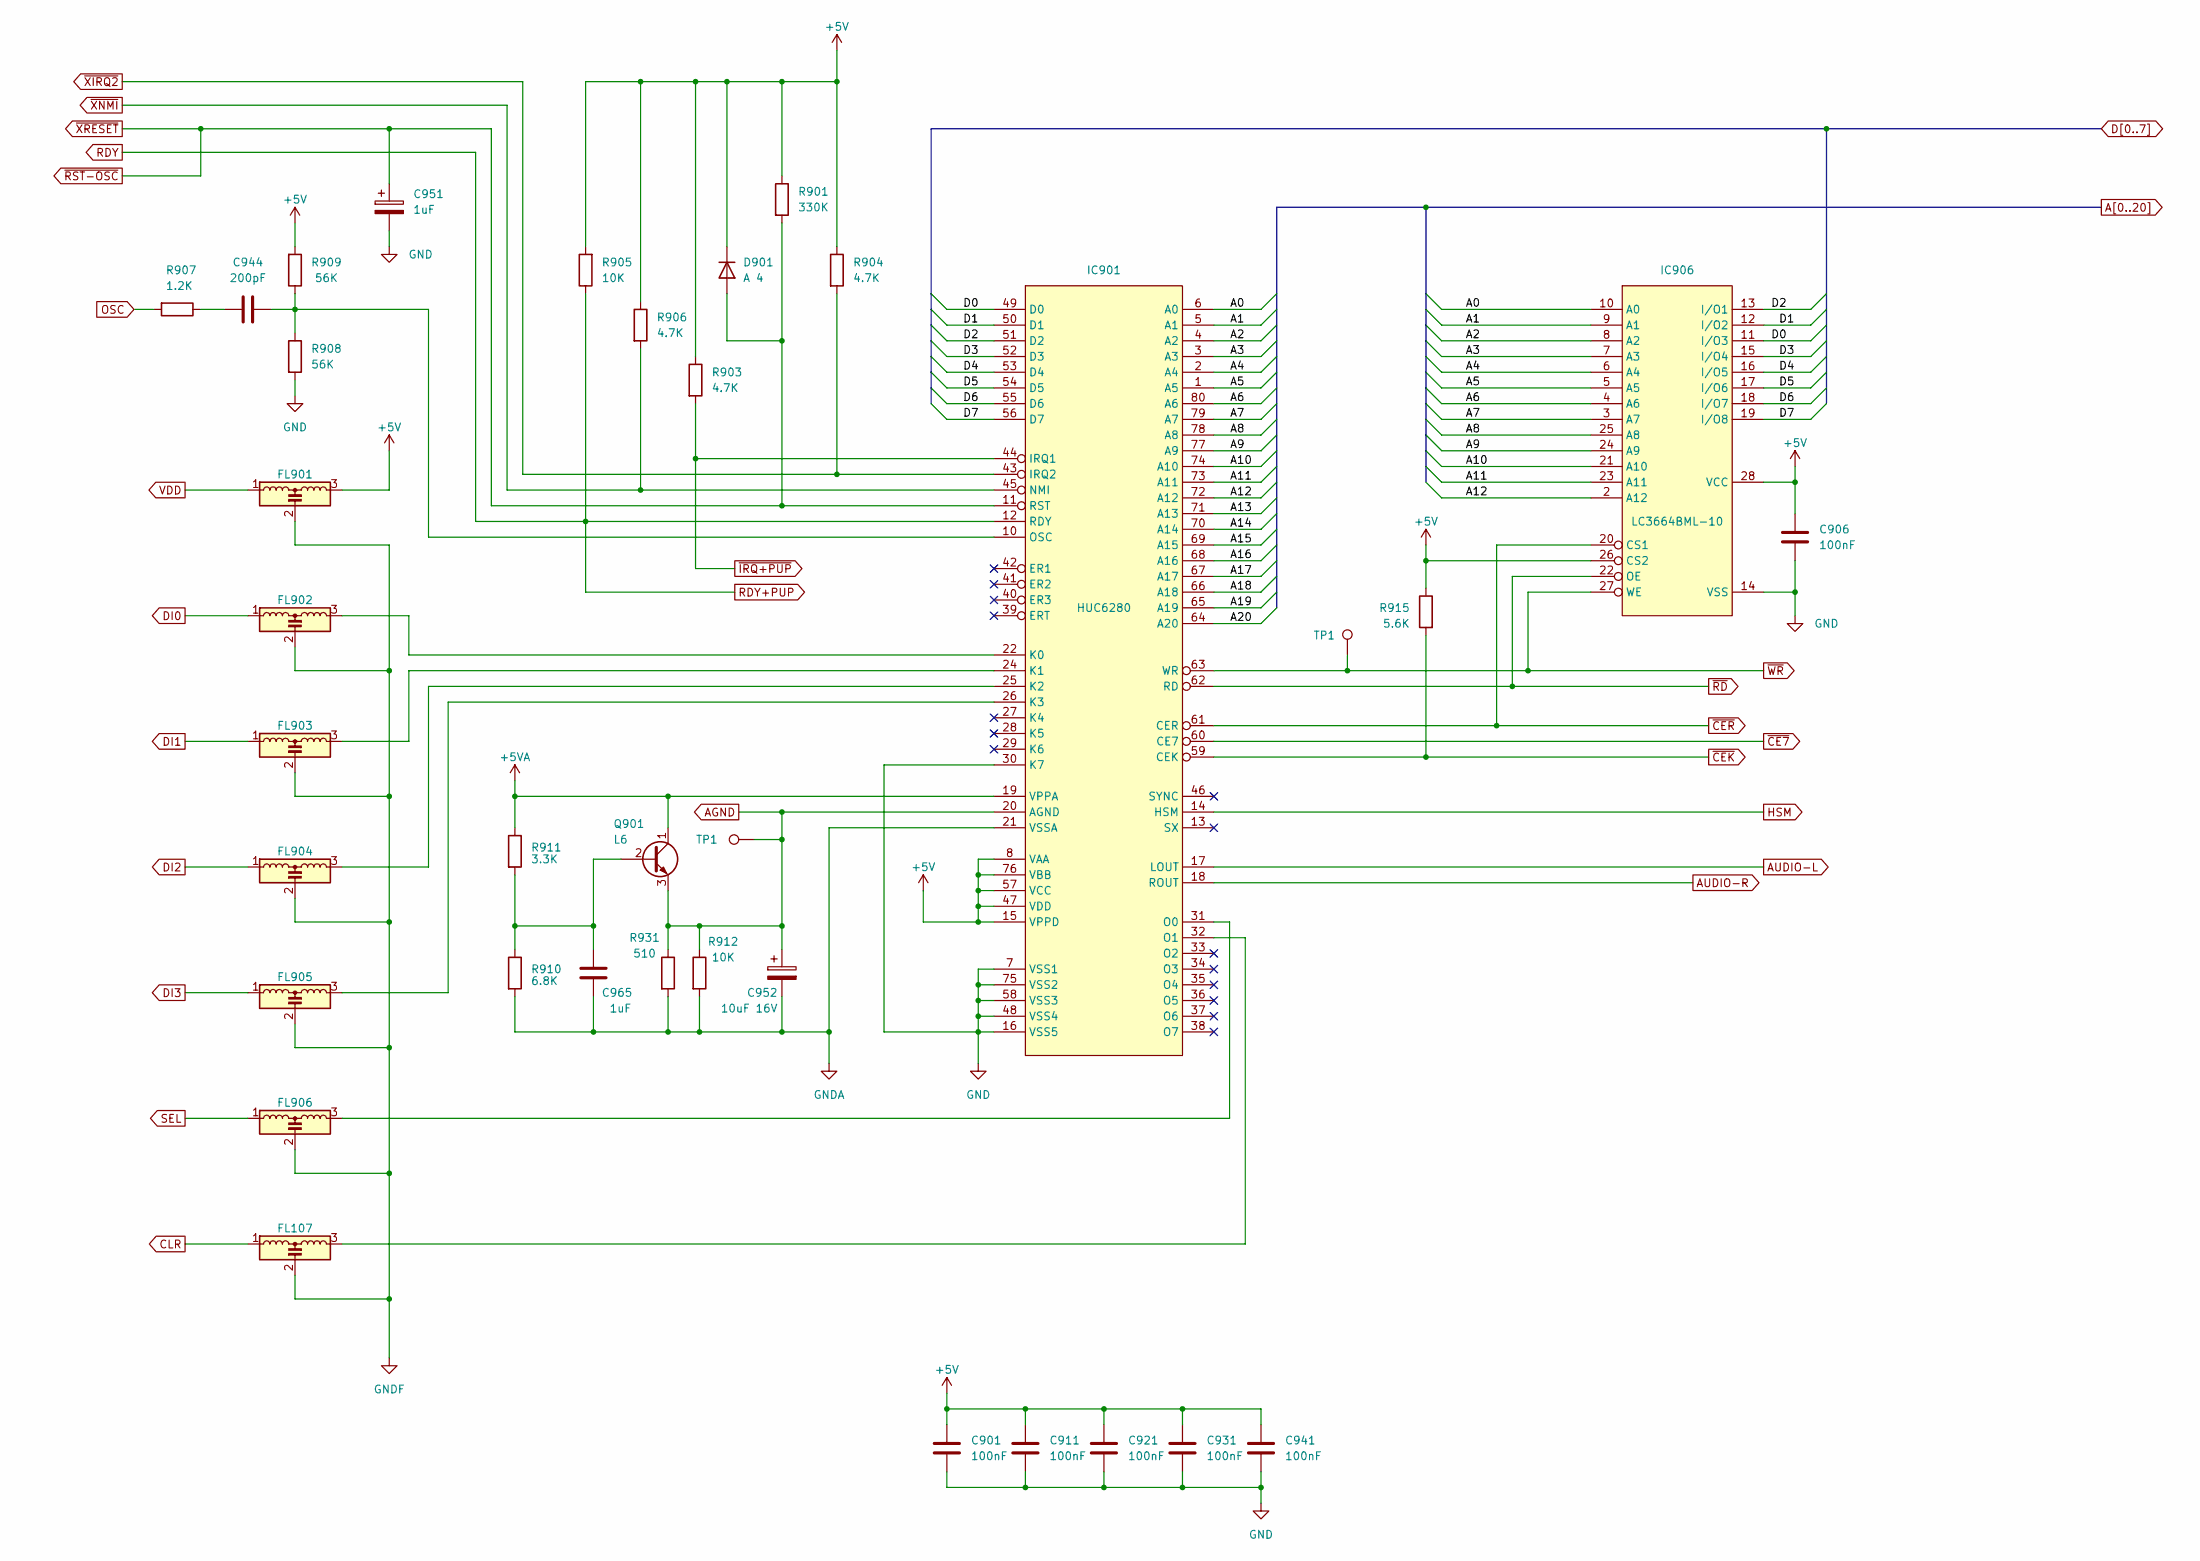
[picture p5: schematic cpu.kicad_sch]

Parts:
C901, C911, C921, C931, C941: 100nF; SMD_0805_Narrow
C906: 100nF; SMD_0805_Narrow_Long
C944: 200pF; SMD_0805_Narrow_Long
C951: 1uF; SMD_0805_Narrow_Long
C952: 10uF 16V; CP_2010_XL
C965: 1uF; SMD_0805_Narrow
D901: A 4; Transistor_SMD
FL107, FL901, FL902, FL903, FL904, FL905, FL906: Filter_EMI_LCL; FL-5.00mm
IC901: HUC6280; HUC62xx
IC906: LC3664BML-10; HSRM20256LM
Q901: L6; Transistor_SMD
R901: 330K; SMD_0805_Narrow_Long
R903, R904, R906: 4.7K; SMD_0805_Narrow
R905: 10K; SMD_0805_Narrow
R907: 1.2K; SMD_0805_Narrow_Long
R908, R909: 56K; SMD_0805_Narrow_Long
R910: 6.8K; SMD_0805_Narrow_Long
R911: 3.3K; SMD_0805_Narrow
R912: 10K; SMD_0805_Narrow_Long
R915: 5.6K; SMD_0805_Narrow
R931: 510; SMD_0805_Narrow_Long
TP1: Test_Point_1.5mm

Connections:
+5V: C901.1, C906.1, C911.1, C921.1, C931.1, C941.1, D901.3 (K), FL901.3, IC901.8 (VAA), IC901.15 (VPPD), IC901.47 (VDD), IC901.57 (VCC), IC901.76 (VBB), IC906.26 (CS2), IC906.28 (VCC), R901.1, R903.1, R904.1, R905.2, R906.1, R909.2, R915.1
+5VA: IC901.19 (VPPA), Q901.1 (C), R911.1
A0: IC901.6 (A0), IC906.10 (A0)
A1: IC901.5 (A1), IC906.9 (A1)
A2: IC901.4 (A2), IC906.8 (A2)
A3: IC901.3 (A3), IC906.7 (A3)
A4: IC901.2 (A4), IC906.6 (A4)
A5: IC901.1 (A5), IC906.5 (A5)
A6: IC901.80 (A6), IC906.4 (A6)
A7: IC901.79 (A7), IC906.3 (A7)
A8: IC901.78 (A8), IC906.25 (A8)
A9: IC901.77 (A9), IC906.24 (A9)
A10: IC901.74 (A10), IC906.21 (A10)
A11: IC901.73 (A11), IC906.23 (A11)
A12: IC901.72 (A12), IC906.2 (A12)
A13: IC901.71 (A13)
A14: IC901.70 (A14)
A15: IC901.69 (A15)
A16: IC901.68 (A16)
A17: IC901.67 (A17)
A18: IC901.66 (A18)
A19: IC901.65 (A19)
A20: IC901.64 (A20)
AGND: C952.1, IC901.20 (AGND), Q901.3 (E), R912.1, R931.1, TP1.1
AUDIO-L: IC901.17 (LOUT)
AUDIO-R: IC901.18 (ROUT)
CLR: FL107.1
D0: IC901.49 (D0), IC906.11 (I/O3)
D1: IC901.50 (D1), IC906.12 (I/O2)
D2: IC901.51 (D2), IC906.13 (I/O1)
D3: IC901.52 (D3), IC906.15 (I/O4)
D4: IC901.53 (D4), IC906.16 (I/O5)
D5: IC901.54 (D5), IC906.17 (I/O6)
D6: IC901.55 (D6), IC906.18 (I/O7)
D7: IC901.56 (D7), IC906.19 (I/O8)
DI0: FL902.1
DI1: FL903.1
DI2: FL904.1
DI3: FL905.1
GND: C901.2, C906.2, C911.2, C921.2, C931.2, C941.2, C951.2, IC901.7 (VSS1), IC901.16 (VSS5), IC901.30 (K7), IC901.48 (VSS4), IC901.58 (VSS3), IC901.75 (VSS2), IC906.14 (VSS), R908.2
GNDA: C952.2, C965.2, IC901.21 (VSSA), R910.2, R912.2, R931.2
GNDF: FL107.2, FL901.2, FL902.2, FL903.2, FL904.2, FL905.2, FL906.2
HSM: IC901.14 (HSM)
unnamed: C944.1, R907.1
unnamed: C944.2, IC901.10 (OSC), R908.1, R909.1
unnamed: C965.1, Q901.2 (B), R910.1, R911.2
unnamed: FL107.3, IC901.32 (O1)
unnamed: FL902.3, IC901.22 (K0)
unnamed: FL903.3, IC901.24 (K1)
unnamed: FL904.3, IC901.25 (K2)
unnamed: FL905.3, IC901.26 (K3)
unnamed: FL906.3, IC901.31 (O0)
OSC: R907.2
RDY: IC901.12 (RDY), R905.1
SEL: FL906.1
VDD: FL901.1
~CE7: IC901.60 (CE7)
~CEK: IC901.59 (CEK), R915.2
~CER: IC901.61 (CER), IC906.20 (CS1)
~IRQ+PUP: IC901.44 (IRQ1), R903.2
~RD: IC901.62 (RD), IC906.22 (OE)
~RST-OSC: C951.1, D901.1 (A), IC901.11 (RST), R901.2
~WR: IC901.63 (WR), IC906.27 (WE), TP1.1
~XIRQ2: IC901.43 (IRQ2), R904.2
~XNMI: IC901.45 (NMI), R906.2
