Board-Folk/PC-Engine-Duo/interface.kicad_sch

## KiCad design interface.kicad_sch (2023-11-11)

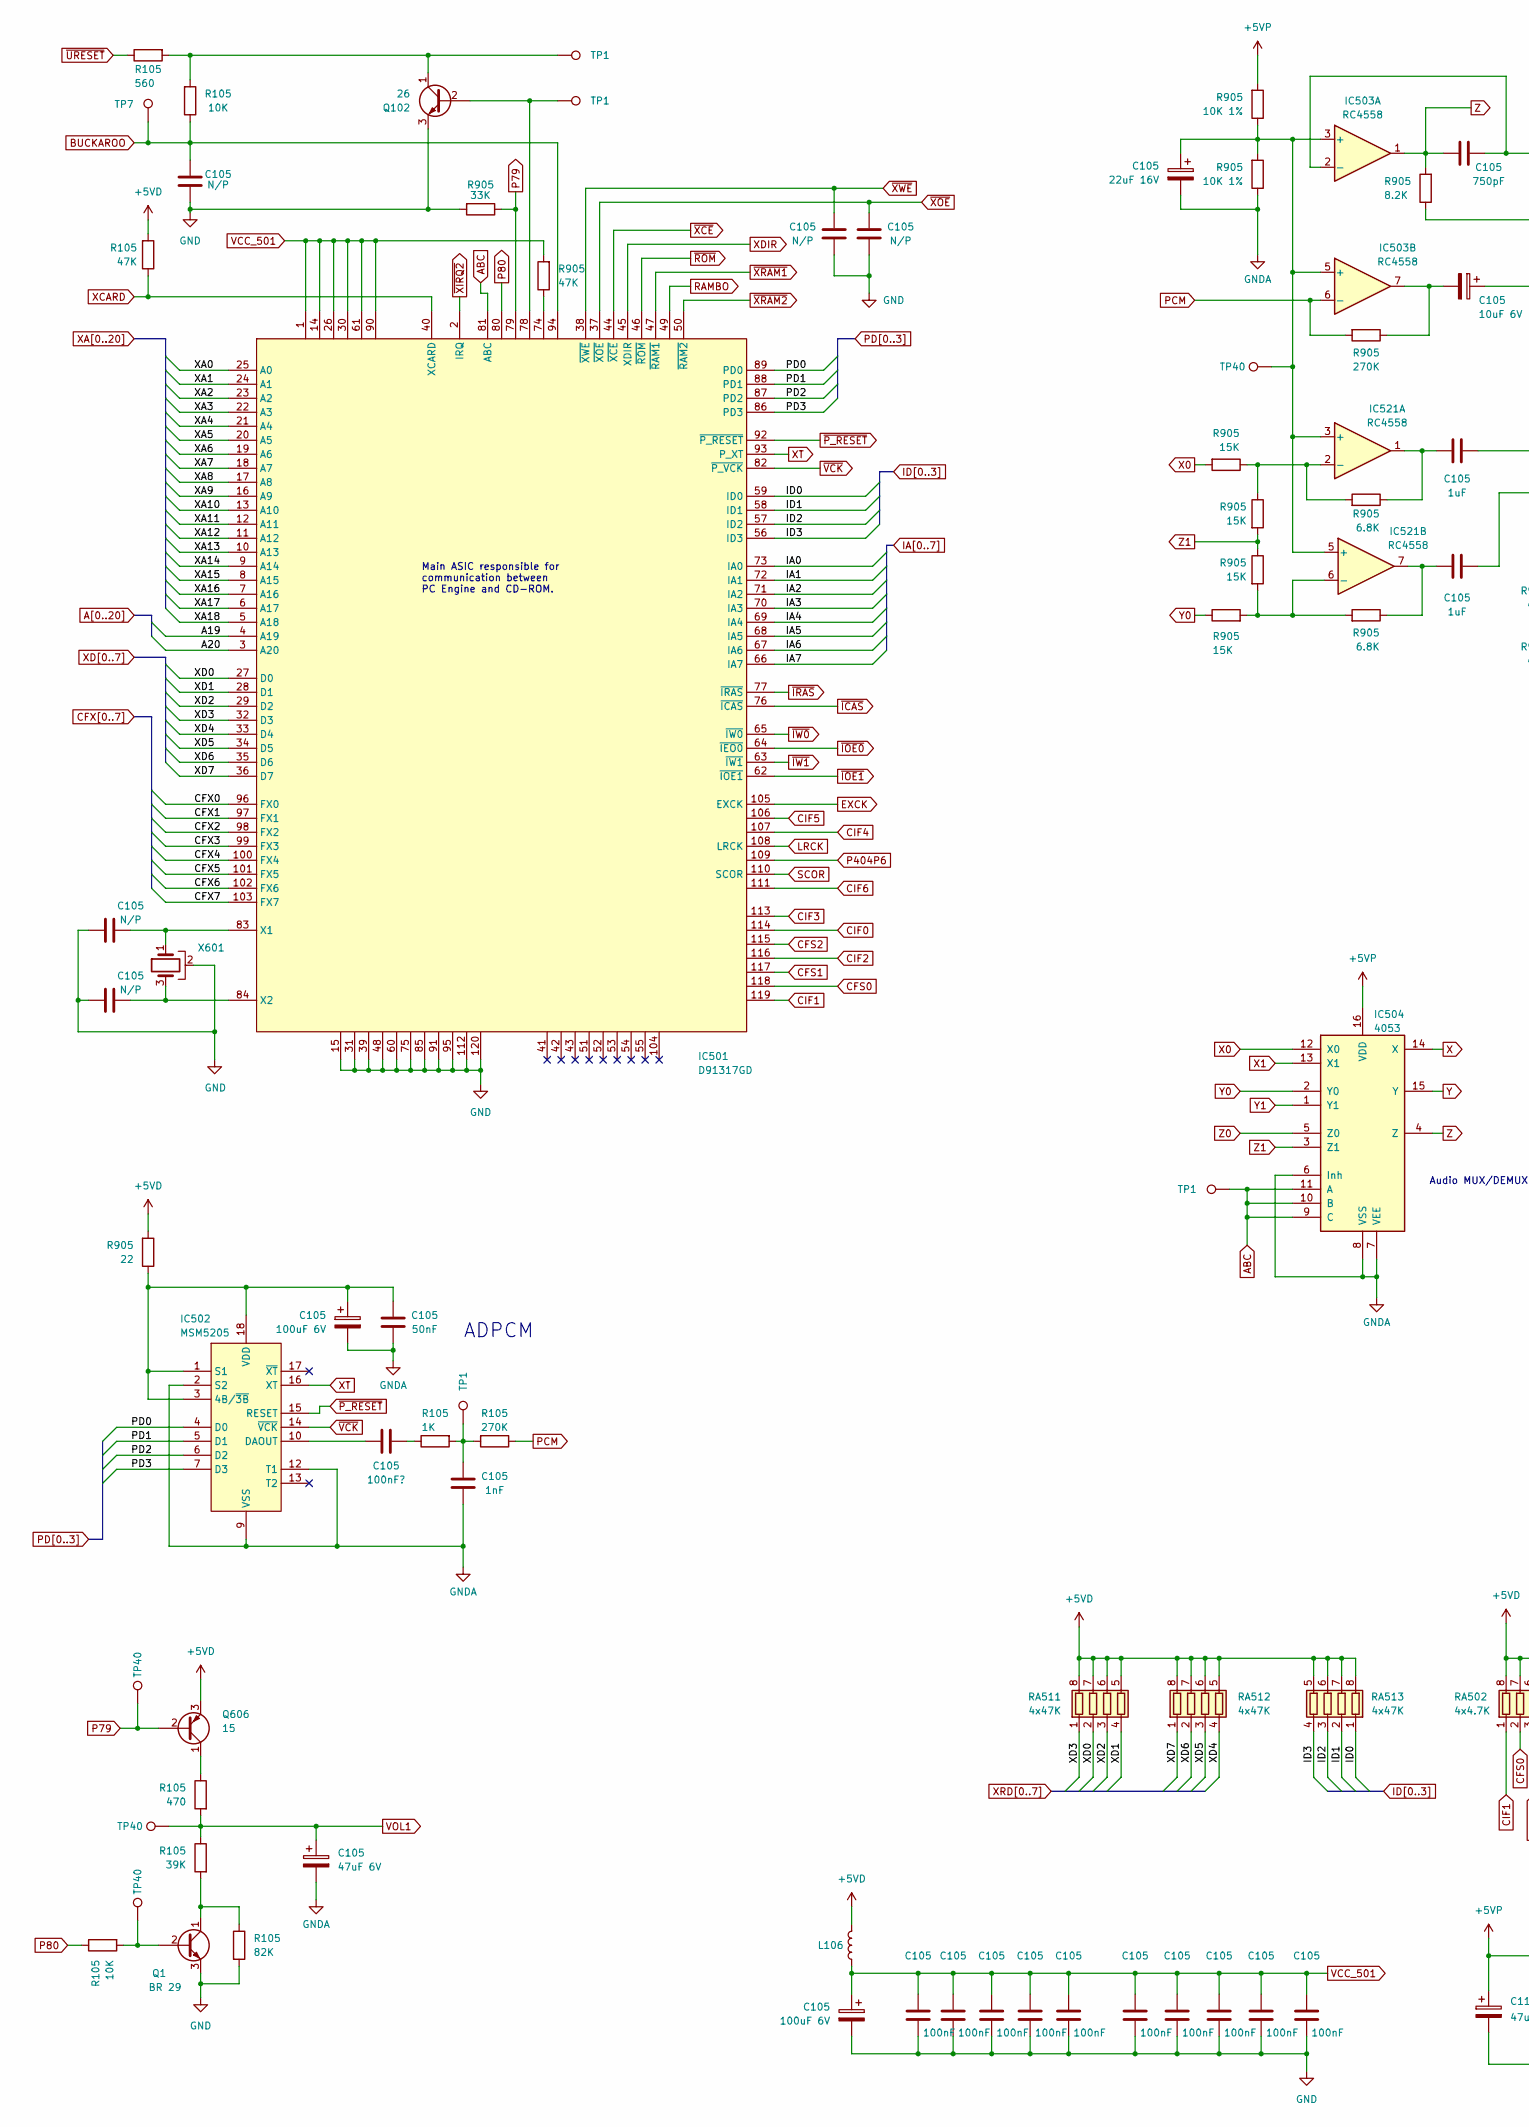
[picture p6: schematic interface.kicad_sch, part in row 1, column 1]

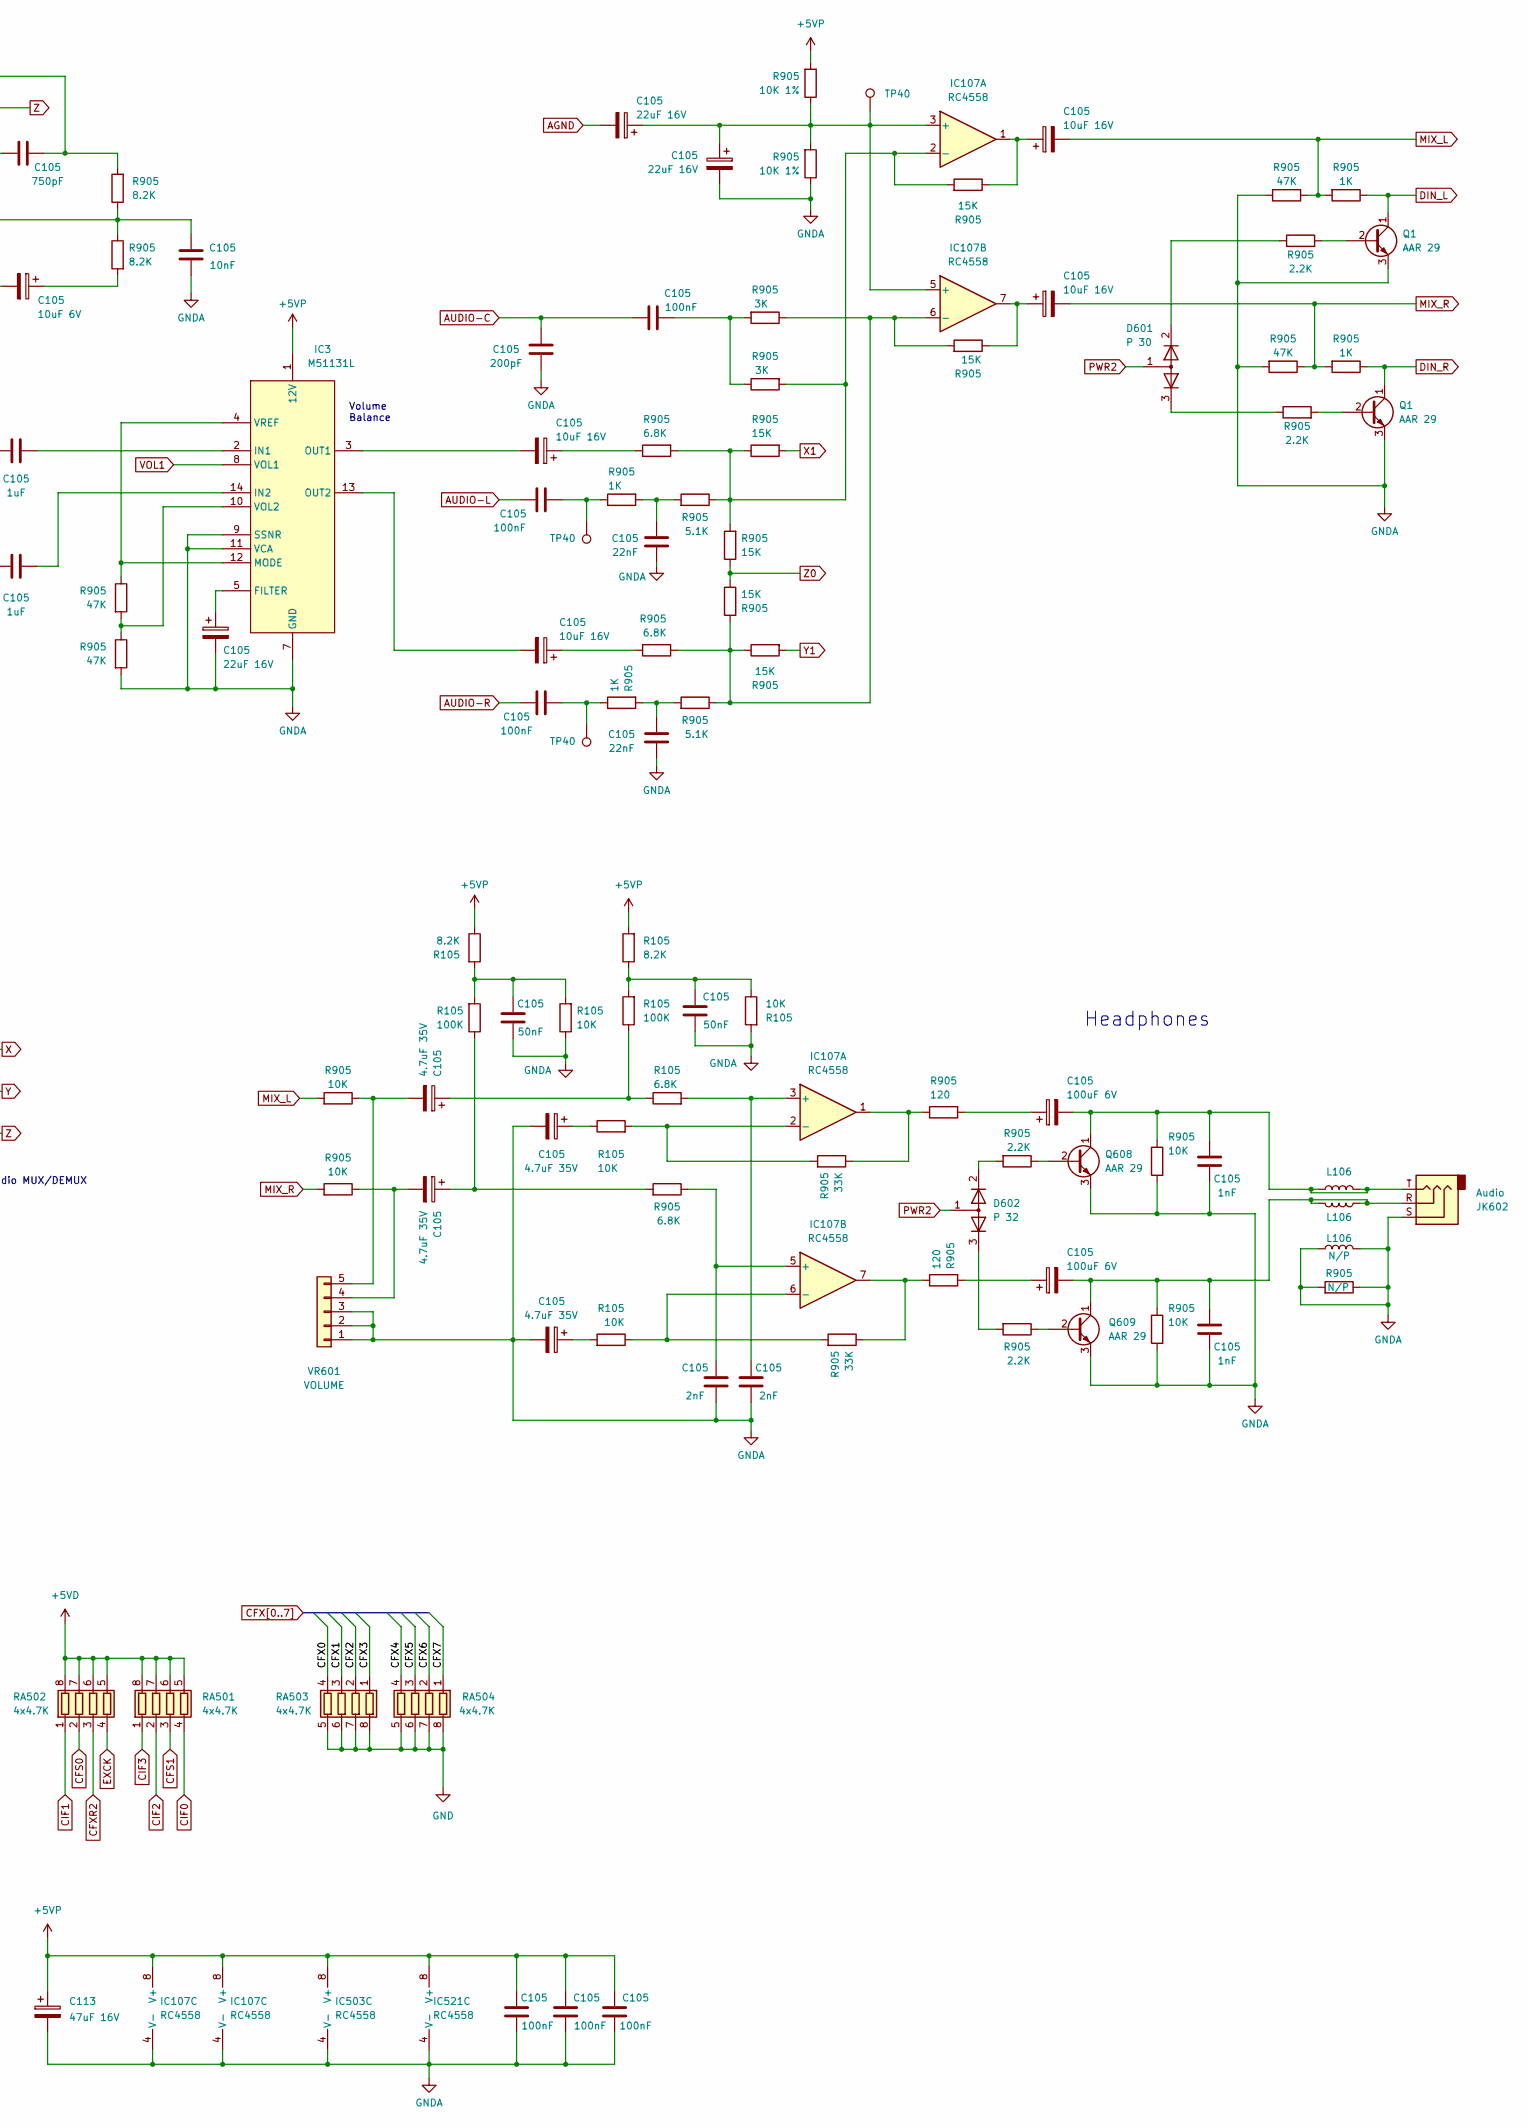
[picture p7: schematic interface.kicad_sch, part in row 1, column 2]

Parts:
C105: 10nF; SMD_0805_Narrow
C113: 47uF 16V; CP_8x2mm
D601: P 30; Transistor_SMD
D602: P 32; Transistor_SMD
IC3: M51131L; ZIP-14
IC107: RC4558; SO-8_P1.27mm
IC501: D91317GD; QFP-120_26x26_Pitch0.8mm
IC502: MSM5205; DIP-18_W
IC503, IC521: RC4558; SO-8_P1.27mm_Gutters
IC504: 4053; SO-16_P1.27mm_Gutters
JK602: Audio; Duo_Audio_Jack
L106: SMD_0805_Narrow
Q1: BR 29; Transistor_SMD
Q102: 26; Transistor_SMD
Q606: 15; Transistor_SMD
Q608, Q609: AAR 29; Transistor_SMD
R105: 470; SMD_0805_Narrow_Long
R905: 22; SMD_0805_Narrow
RA501, RA502, RA503, RA504: 4x4.7K; R_Array_4x0603
RA511, RA512, RA513: 4x47K; R_Array_4x0603
TP1, TP7, TP40: Test_Point_1.5mm
VR601: VOLUME; Duo_Dial_5P
X601: Crystal_5x10mm

Connections:
+5VD: L106.2, Q606.3 (E), R105.2, R905.2, RA501.5 (R4.2), RA501.6 (R3.2), RA501.7 (R2.2), RA501.8 (R1.2), RA502.5 (R4.2), RA502.6 (R3.2), RA502.7 (R2.2), RA502.8 (R1.2), RA511.5 (R4.2), RA511.6 (R3.2), RA511.7 (R2.2), RA511.8 (R1.2), RA512.5 (R4.2), RA512.6 (R3.2), RA512.7 (R2.2), RA512.8 (R1.2), RA513.5 (R4.2), RA513.6 (R3.2), RA513.7 (R2.2), RA513.8 (R1.2)
+5VP: C105.1, C105.2, C113.1, IC3.1 (12V), IC107.8 (V+), IC503.8 (V+), IC504.16 (VDD), IC521.8 (V+), R105.1, R105.2, R905.2
A19: IC501.4 (A19)
A20: IC501.3 (A20)
ABC: IC501.81 (ABC), IC504.9 (C), IC504.10 (B), IC504.11 (A), TP1.1
AGND: C105.2
AUDIO-C: C105.1
AUDIO-L: C105.1
AUDIO-R: C105.1
BUCKAROO: C105.2, IC501.94, R105.1, TP7.1
CFS0: IC501.118, RA502.2 (R2.1)
CFS1: IC501.117, RA501.3 (R3.1)
CFS2: IC501.115
CFX0: IC501.96 (FX0), RA503.4 (R4.1)
CFX1: IC501.97 (FX1), RA503.3 (R3.1)
CFX2: IC501.98 (FX2), RA503.2 (R2.1)
CFX3: IC501.99 (FX3), RA503.1 (R1.1)
CFX4: IC501.100 (FX4), RA504.4 (R4.1)
CFX5: IC501.101 (FX5), RA504.3 (R3.1)
CFX6: IC501.102 (FX6), RA504.2 (R2.1)
CFX7: IC501.103 (FX7), RA504.1 (R1.1)
CFXR2: RA502.3 (R3.1)
CIF0: IC501.114, RA501.4 (R4.1)
CIF1: IC501.119, RA502.1 (R1.1)
CIF2: IC501.116, RA501.2 (R2.1)
CIF3: IC501.113, RA501.1 (R1.1)
CIF4: IC501.107
CIF5: IC501.106
CIF6: IC501.111
DIN_L: Q1.1 (C), R905.1
DIN_R: Q1.1 (C), R905.1
EXCK: IC501.105 (EXCK), RA502.4 (R4.1)
GND: C105.1, C105.2, IC501.15, IC501.31, IC501.39, IC501.48, IC501.60, IC501.75, IC501.85, IC501.91, IC501.95, IC501.112, IC501.120, Q1.3 (E), Q102.3 (E), R105.2, R905.2, RA503.5 (R4.2), RA503.6 (R3.2), RA503.7 (R2.2), RA503.8 (R1.2), RA504.5 (R4.2), RA504.6 (R3.2), RA504.7 (R2.2), RA504.8 (R1.2), X601.2
GNDA: C105.1, C105.2, C113.2, IC3.7 (GND), IC3.9 (SSNR), IC3.11 (VCA), IC107.4 (V-), IC502.2 (S2), IC502.9 (VSS), IC502.12 (T1), IC503.4 (V-), IC504.6 (Inh), IC504.7 (VEE), IC504.8 (VSS), IC521.4 (V-), JK602.S, L106.1, L106.2, Q1.3 (E), Q608.3 (E), Q609.3 (E), R105.1, R105.2, R905.1, R905.2, VR601.1, VR601.2, VR601.3
IA0: IC501.73 (IA0)
IA1: IC501.72 (IA1)
IA2: IC501.71 (IA2)
IA3: IC501.70 (IA3)
IA4: IC501.69 (IA4)
IA5: IC501.68 (IA5)
IA6: IC501.67 (IA6)
IA7: IC501.66 (IA7)
ID0: IC501.59 (ID0), RA513.1 (R1.1)
ID1: IC501.58 (ID1), RA513.2 (R2.1)
ID2: IC501.57 (ID2), RA513.3 (R3.1)
ID3: IC501.56 (ID3), RA513.4 (R4.1)
LRCK: IC501.108 (LRCK)
MIX_L: C105.2, R905.1, R905.2
MIX_R: C105.2, R905.1, R905.2
unnamed: C105.1, IC3.2 (IN1), IC3.5 (FILTER), IC3.14 (IN2), IC107.1, IC107.3 (+), IC107.5 (+), IC107.7, IC501.83 (X1), IC501.84 (X2), IC502.1 (S1), IC502.3 (4B/~3B), IC502.10 (DAOUT), IC502.18 (VDD), IC503.3 (+), IC503.5 (+), IC521.3 (+), IC521.5 (+), R105.1, R105.2, R905.1, R905.2, TP40.1, X601.1, X601.3
unnamed: C105.2, IC3.3 (OUT1), IC3.13 (OUT2), IC107.3 (+), IC503.2 (-), IC503.7, IC521.1, IC521.7, JK602.R, JK602.T, L106.1, L106.2, Q608.1 (C), Q609.1 (C), R105.1, R105.2, R905.1, R905.2, TP1.1, TP40.1, VR601.4, VR601.5
unnamed: D601.2 (K), R905.1
unnamed: D601.3 (K), R905.1
unnamed: D602.2 (K), R905.2
unnamed: D602.3 (K), R905.2
unnamed: IC3.10 (VOL2), R905.1, R905.2
unnamed: IC3.4 (VREF), IC3.12 (MODE), R905.1
unnamed: IC107.1, R905.1
unnamed: IC107.2 (-), R105.2, R905.1, R905.2
unnamed: IC107.6 (-), R105.1, R905.1, R905.2
unnamed: IC107.7, R905.1
unnamed: IC501.74, R905.1
unnamed: IC501.78, Q102.2 (B), TP1.1
unnamed: IC521.2 (-), R905.1, R905.2
unnamed: IC521.6 (-), R905.2
unnamed: Q1.1 (C), R105.1, R105.2
unnamed: Q1.2 (B), R105.2, R905.2, TP40.1
unnamed: Q102.1 (C), R105.2, TP1.1
unnamed: Q606.1 (C), R105.1
unnamed: Q608.2 (B), R905.1
unnamed: Q609.2 (B), R905.1
P79: IC501.79, Q606.2 (B), R905.1, TP40.1
P80: IC501.80, R105.1
P404P6: IC501.109
PCM: IC503.6 (-), R105.1, R905.2
PD0: IC501.89 (PD0), IC502.4 (D0)
PD1: IC501.88 (PD1), IC502.5 (D1)
PD2: IC501.87 (PD2), IC502.6 (D2)
PD3: IC501.86 (PD3), IC502.7 (D3)
PWR2: D601.1 (A), D602.1 (A)
RAMBO: IC501.49
SCOR: IC501.110 (SCOR)
VCC_501: C105.1, C105.2, IC501.1, IC501.14, IC501.26, IC501.30, IC501.61, IC501.90, L106.1, R905.2
VOL1: C105.1, IC3.8 (VOL1), R105.1, R105.2, TP40.1
X: IC504.14 (X)
X0: IC504.12 (X0), R905.2
X1: IC504.13 (X1), R905.2
XA0: IC501.25 (A0)
XA1: IC501.24 (A1)
XA2: IC501.23 (A2)
XA3: IC501.22 (A3)
XA4: IC501.21 (A4)
XA5: IC501.20 (A5)
XA6: IC501.19 (A6)
XA7: IC501.18 (A7)
XA8: IC501.17 (A8)
XA9: IC501.16 (A9)
XA10: IC501.13 (A10)
XA11: IC501.12 (A11)
XA12: IC501.11 (A12)
XA13: IC501.10 (A13)
XA14: IC501.9 (A14)
XA15: IC501.8 (A15)
XA16: IC501.7 (A16)
XA17: IC501.6 (A17)
XA18: IC501.5 (A18)
XCARD: IC501.40 (XCARD), R105.1
XD0: IC501.27 (D0), RA511.2 (R2.1)
XD1: IC501.28 (D1), RA511.4 (R4.1)
XD2: IC501.29 (D2), RA511.3 (R3.1)
XD3: IC501.32 (D3), RA511.1 (R1.1)
XD4: IC501.33 (D4), RA512.4 (R4.1)
XD5: IC501.34 (D5), RA512.3 (R3.1)
XD6: IC501.35 (D6), RA512.2 (R2.1)
XD7: IC501.36 (D7), RA512.1 (R1.1)
XDIR: IC501.45 (XDIR)
XT: IC501.93 (P_XT), IC502.16 (XT)
Y: IC504.15 (Y)
Y0: IC504.2 (Y0), R905.1
Y1: IC504.1 (Y1), R905.2
Z: C105.1, IC503.1, IC504.4 (Z), R905.2
Z0: IC504.5 (Z0), R905.1
Z1: IC504.3 (Z1), R905.1, R905.2
~ICAS: IC501.76 (~ICAS)
~IOE0: IC501.64 (~IEO0)
~IOE1: IC501.62 (~IOE1)
~IRAS: IC501.77 (~IRAS)
~IW0: IC501.65 (~IW0)
~IW1: IC501.63 (~IW1)
~P_RESET: IC501.92 (~P_RESET), IC502.15 (RESET)
~ROM: IC501.46 (~ROM)
~URESET: R105.1
~VCK: IC501.82 (~P_VCK), IC502.14 (~VCK)
~XCE: IC501.44 (~XCE)
~XIRQ2: IC501.2 (IRQ)
~XOE: C105.2, IC501.37 (~XOE)
~XRAM1: IC501.47 (~RAM1)
~XRAM2: IC501.50 (~RAM2)
~XWE: C105.2, IC501.38 (~XWE)

Notes on the sheet:
Main ASIC responsible for communication between PC Engine and CD-ROM.
Audio MUX/DEMUX
ADPCM
Volume Balance
Headphones
