Board-Folk/PC-Engine-Duo/interface_memory.kicad_sch

## KiCad design interface_memory.kicad_sch (2023-11-11)

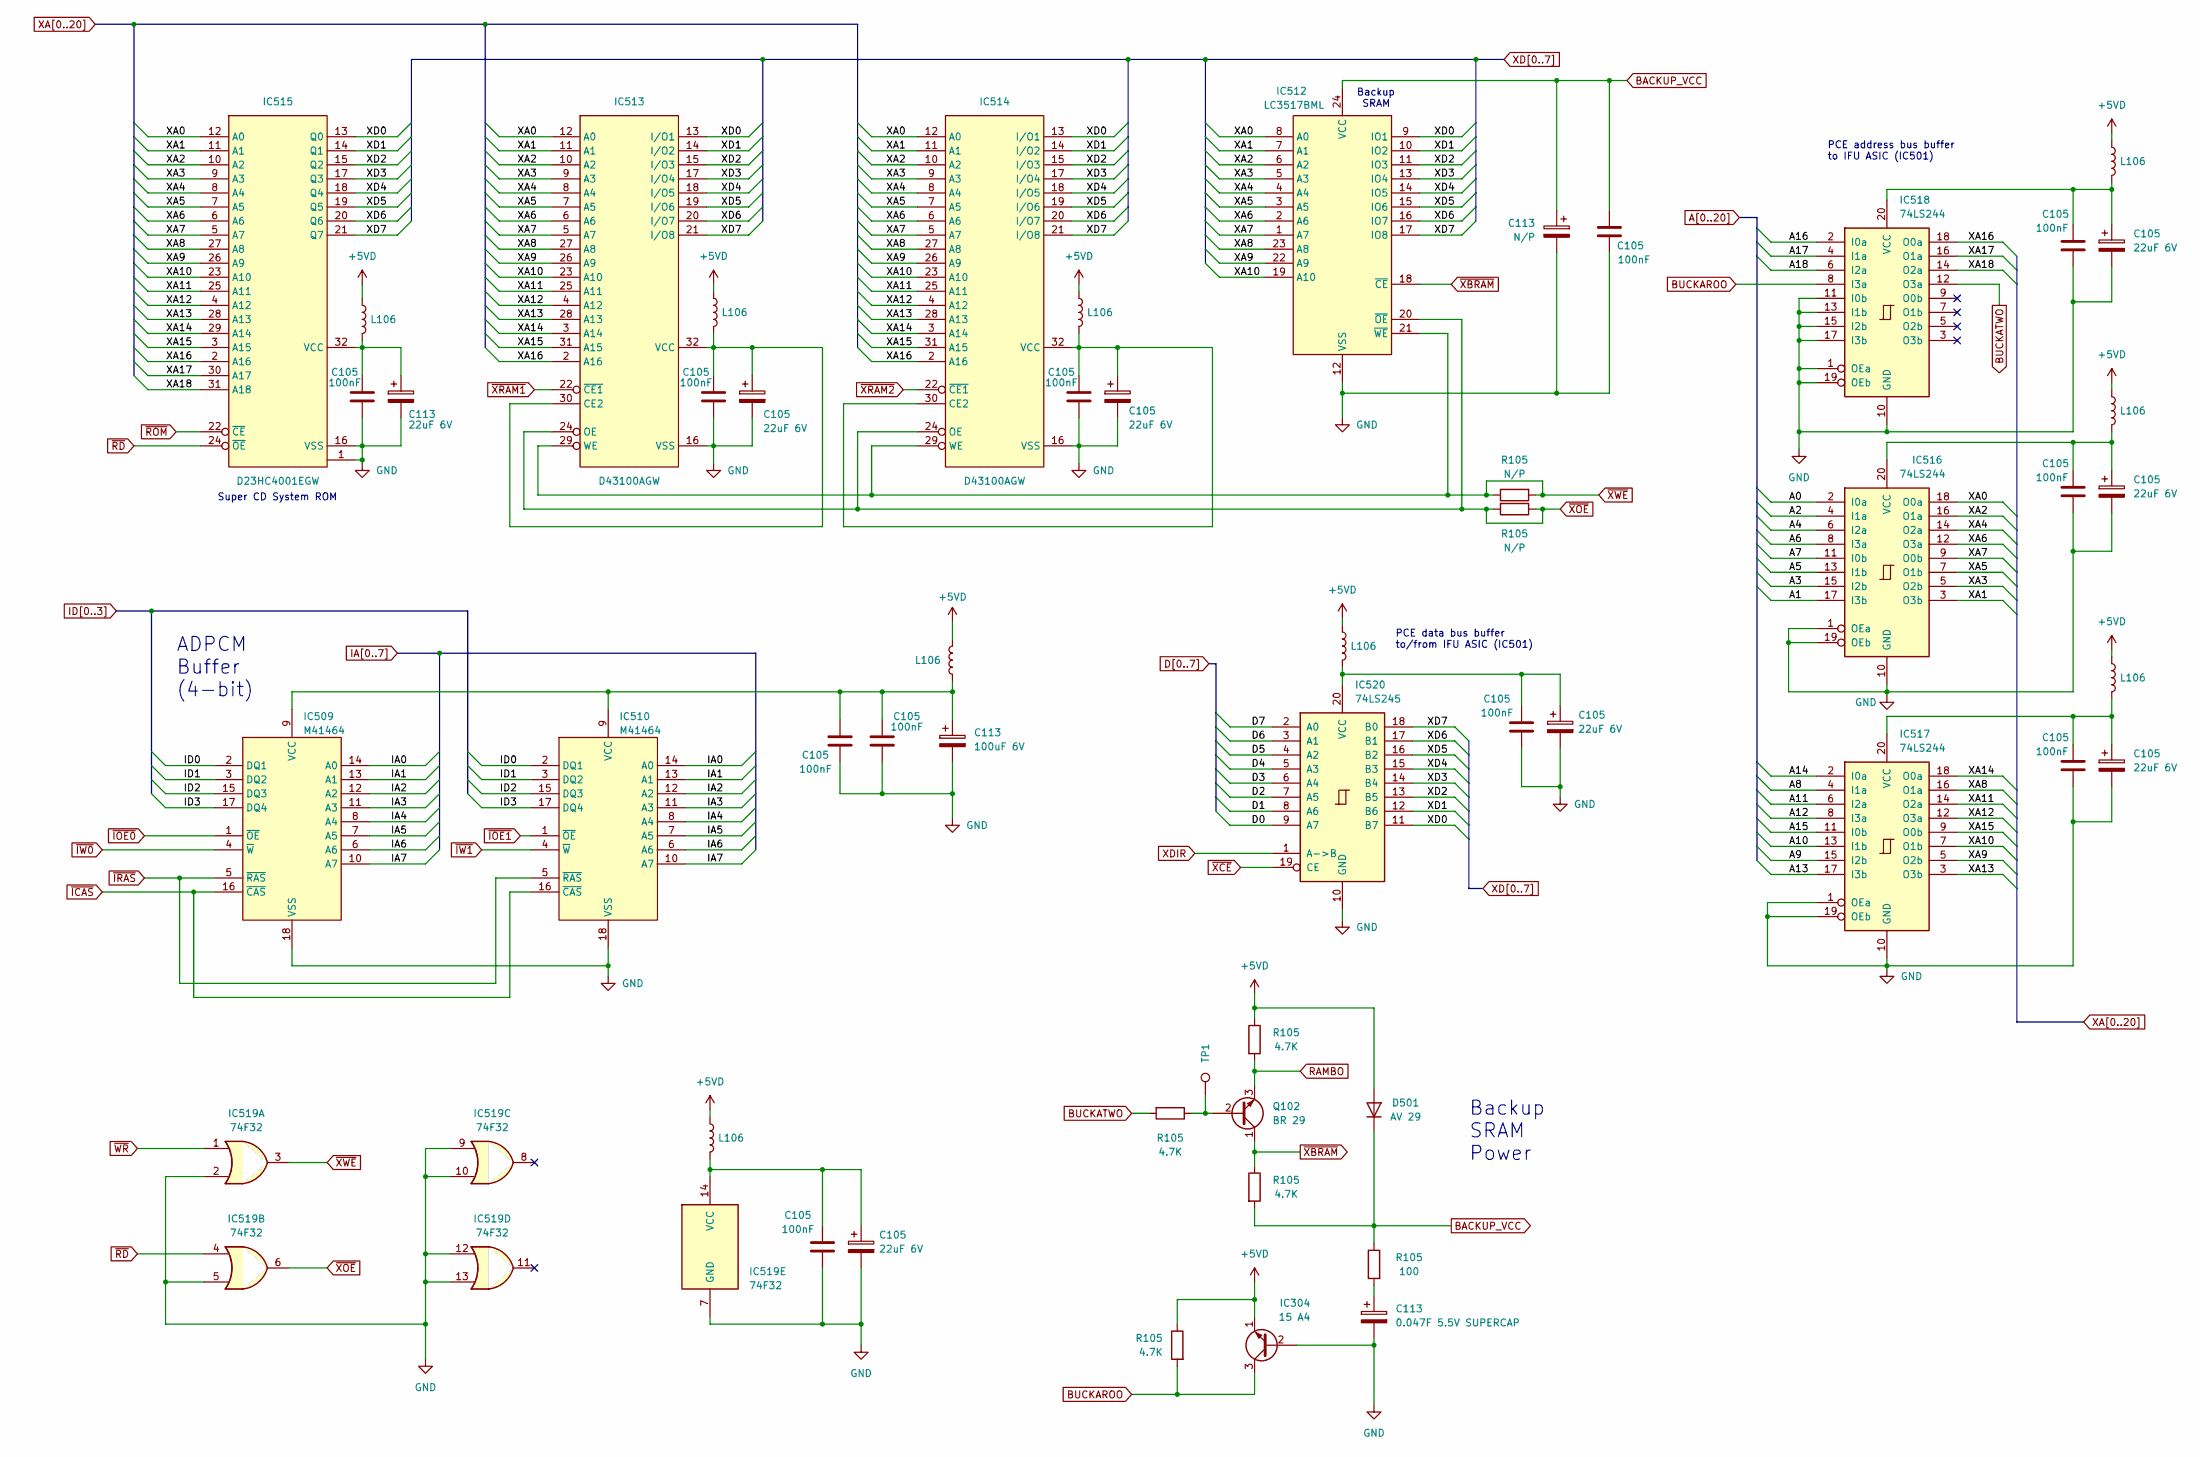
[picture p8: schematic interface_memory.kicad_sch]

Parts:
C105: 100nF; SMD_0805_Narrow_Long
C113: N/P; CP_6x1.5mm
D501: AV 29; Transistor_SMD
IC304: 15 A4; SOT-89-3
IC509, IC510: M41464; QFP-18_10x6_Pitch1.25mm
IC512: LC3517BML; SOIC-24W_P1.27mm
IC513, IC514: D43100AGW; SSOP-32_P1.27mm
IC515: D23HC4001EGW; SSOP-32_P1.27mm
IC516, IC517, IC518: 74LS244; SO-20_P1.27mm_Gutters
IC519: 74F32; SO-14_P1.27mm_Gutters
IC520: 74LS245; SO-20_P1.27mm_Gutters
L106: SMD_0805_Narrow
Q102: BR 29; Transistor_SMD
R105: 4.7K; SMD_0805_Narrow_Long
TP1: Test_Point_1.5mm

Connections:
+5VD: D501.2 (A), IC304.1 (E), L106.1, L106.2, R105.1
A0: IC516.2 (I0a)
A1: IC516.17 (I3b)
A2: IC516.4 (I1a)
A3: IC516.15 (I2b)
A4: IC516.6 (I2a)
A5: IC516.13 (I1b)
A6: IC516.8 (I3a)
A7: IC516.11 (I0b)
A8: IC517.4 (I1a)
A9: IC517.15 (I2b)
A10: IC517.13 (I1b)
A11: IC517.6 (I2a)
A12: IC517.8 (I3a)
A13: IC517.17 (I3b)
A14: IC517.2 (I0a)
A15: IC517.11 (I0b)
A16: IC518.2 (I0a)
A17: IC518.4 (I1a)
A18: IC518.6 (I2a)
BACKUP_VCC: C105.2, C113.1, D501.1 (K), IC512.24 (VCC), R105.1, R105.2
BUCKAROO: IC304.3 (C), IC518.8 (I3a), R105.2
BUCKATWO: IC518.12 (O3a), R105.2
D0: IC520.9 (A7)
D1: IC520.8 (A6)
D2: IC520.7 (A5)
D3: IC520.6 (A4)
D4: IC520.5 (A3)
D5: IC520.4 (A2)
D6: IC520.3 (A1)
D7: IC520.2 (A0)
GND: C105.1, C105.2, C113.2, IC304.2 (B), IC509.18 (VSS), IC510.18 (VSS), IC512.12 (VSS), IC513.16 (VSS), IC514.16 (VSS), IC515.1, IC515.16 (VSS), IC516.1 (OEa), IC516.10 (GND), IC516.19 (OEb), IC517.1 (OEa), IC517.10 (GND), IC517.19 (OEb), IC518.1 (OEa), IC518.10 (GND), IC518.11 (I0b), IC518.13 (I1b), IC518.15 (I2b), IC518.17 (I3b), IC518.19 (OEb), IC519.2, IC519.5, IC519.7 (GND), IC519.9, IC519.10, IC519.12, IC519.13, IC520.10 (GND)
IA0: IC509.14 (A0), IC510.14 (A0)
IA1: IC509.13 (A1), IC510.13 (A1)
IA2: IC509.12 (A2), IC510.12 (A2)
IA3: IC509.11 (A3), IC510.11 (A3)
IA4: IC509.8 (A4), IC510.8 (A4)
IA5: IC509.7 (A5), IC510.7 (A5)
IA6: IC509.6 (A6), IC510.6 (A6)
IA7: IC509.10 (A7), IC510.10 (A7)
ID0: IC509.2 (DQ1), IC510.2 (DQ1)
ID1: IC509.3 (DQ2), IC510.3 (DQ2)
ID2: IC509.15 (DQ3), IC510.15 (DQ3)
ID3: IC509.17 (DQ4), IC510.17 (DQ4)
unnamed: C105.1, C105.2, IC513.30 (CE2), IC513.32 (VCC), IC514.30 (CE2), IC514.32 (VCC), IC516.20 (VCC), IC517.20 (VCC), IC518.20 (VCC), IC519.14 (VCC), IC520.20 (VCC), L106.2
unnamed: C105.2, C113.1, IC509.9 (VCC), IC510.9 (VCC), IC515.32 (VCC), L106.1, L106.2
unnamed: C113.1, R105.2
unnamed: Q102.2 (B), R105.1, TP1.1
RAMBO: Q102.3 (E), R105.2
XA0: IC512.8 (A0), IC513.12 (A0), IC514.12 (A0), IC515.12 (A0), IC516.18 (O0a)
XA1: IC512.7 (A1), IC513.11 (A1), IC514.11 (A1), IC515.11 (A1), IC516.3 (O3b)
XA2: IC512.6 (A2), IC513.10 (A2), IC514.10 (A2), IC515.10 (A2), IC516.16 (O1a)
XA3: IC512.5 (A3), IC513.9 (A3), IC514.9 (A3), IC515.9 (A3), IC516.5 (O2b)
XA4: IC512.4 (A4), IC513.8 (A4), IC514.8 (A4), IC515.8 (A4), IC516.14 (O2a)
XA5: IC512.3 (A5), IC513.7 (A5), IC514.7 (A5), IC515.7 (A5), IC516.7 (O1b)
XA6: IC512.2 (A6), IC513.6 (A6), IC514.6 (A6), IC515.6 (A6), IC516.12 (O3a)
XA7: IC512.1 (A7), IC513.5 (A7), IC514.5 (A7), IC515.5 (A7), IC516.9 (O0b)
XA8: IC512.23 (A8), IC513.27 (A8), IC514.27 (A8), IC515.27 (A8), IC517.16 (O1a)
XA9: IC512.22 (A9), IC513.26 (A9), IC514.26 (A9), IC515.26 (A9), IC517.5 (O2b)
XA10: IC512.19 (A10), IC513.23 (A10), IC514.23 (A10), IC515.23 (A10), IC517.7 (O1b)
XA11: IC513.25 (A11), IC514.25 (A11), IC515.25 (A11), IC517.14 (O2a)
XA12: IC513.4 (A12), IC514.4 (A12), IC515.4 (A12), IC517.12 (O3a)
XA13: IC513.28 (A13), IC514.28 (A13), IC515.28 (A13), IC517.3 (O3b)
XA14: IC513.3 (A14), IC514.3 (A14), IC515.29 (A14), IC517.18 (O0a)
XA15: IC513.31 (A15), IC514.31 (A15), IC515.3 (A15), IC517.9 (O0b)
XA16: IC513.2 (A16), IC514.2 (A16), IC515.2 (A16), IC518.18 (O0a)
XA17: IC515.30 (A17), IC518.16 (O1a)
XA18: IC515.31 (A18), IC518.14 (O2a)
XD0: IC512.9 (IO1), IC513.13 (I/O1), IC514.13 (I/O1), IC515.13 (Q0), IC520.11 (B7)
XD1: IC512.10 (IO2), IC513.14 (I/O2), IC514.14 (I/O2), IC515.14 (Q1), IC520.12 (B6)
XD2: IC512.11 (IO3), IC513.15 (I/O3), IC514.15 (I/O3), IC515.15 (Q2), IC520.13 (B5)
XD3: IC512.13 (IO4), IC513.17 (I/O4), IC514.17 (I/O4), IC515.17 (Q3), IC520.14 (B4)
XD4: IC512.14 (IO5), IC513.18 (I/O5), IC514.18 (I/O5), IC515.18 (Q4), IC520.15 (B3)
XD5: IC512.15 (IO6), IC513.19 (I/O6), IC514.19 (I/O6), IC515.19 (Q5), IC520.16 (B2)
XD6: IC512.16 (IO7), IC513.20 (I/O7), IC514.20 (I/O7), IC515.20 (Q6), IC520.17 (B1)
XD7: IC512.17 (IO8), IC513.21 (I/O8), IC514.21 (I/O8), IC515.21 (Q7), IC520.18 (B0)
XDIR: IC520.1 (A->B)
~ICAS: IC509.16 (~CAS), IC510.16 (~CAS)
~IOE0: IC509.1 (~OE)
~IOE1: IC510.1 (~OE)
~IRAS: IC509.5 (~RAS), IC510.5 (~RAS)
~IW0: IC509.4 (~W)
~IW1: IC510.4 (~W)
~RD: IC515.24 (~OE), IC519.4
~ROM: IC515.22 (~CE)
~WR: IC519.1
~XBRAM: IC512.18 (~CE), Q102.1 (C), R105.1
~XCE: IC520.19 (CE)
~XOE: IC512.20 (~OE), IC513.24 (OE), IC514.24 (OE), IC519.6, R105.1, R105.2
~XRAM1: IC513.22 (~CE1)
~XRAM2: IC514.22 (~CE1)
~XWE: IC512.21 (~WE), IC513.29 (WE), IC514.29 (WE), IC519.3, R105.1, R105.2

Notes on the sheet:
Backup SRAM
ADPCM Buffer (4-bit)
PCE address bus buffer to IFU ASIC (IC501)
Super CD System ROM
Backup SRAM Power
PCE data bus buffer to/from IFU ASIC (IC501)
