Board-Folk/PC-Engine-Duo/power.kicad_sch

## KiCad design power.kicad_sch (2023-11-13)

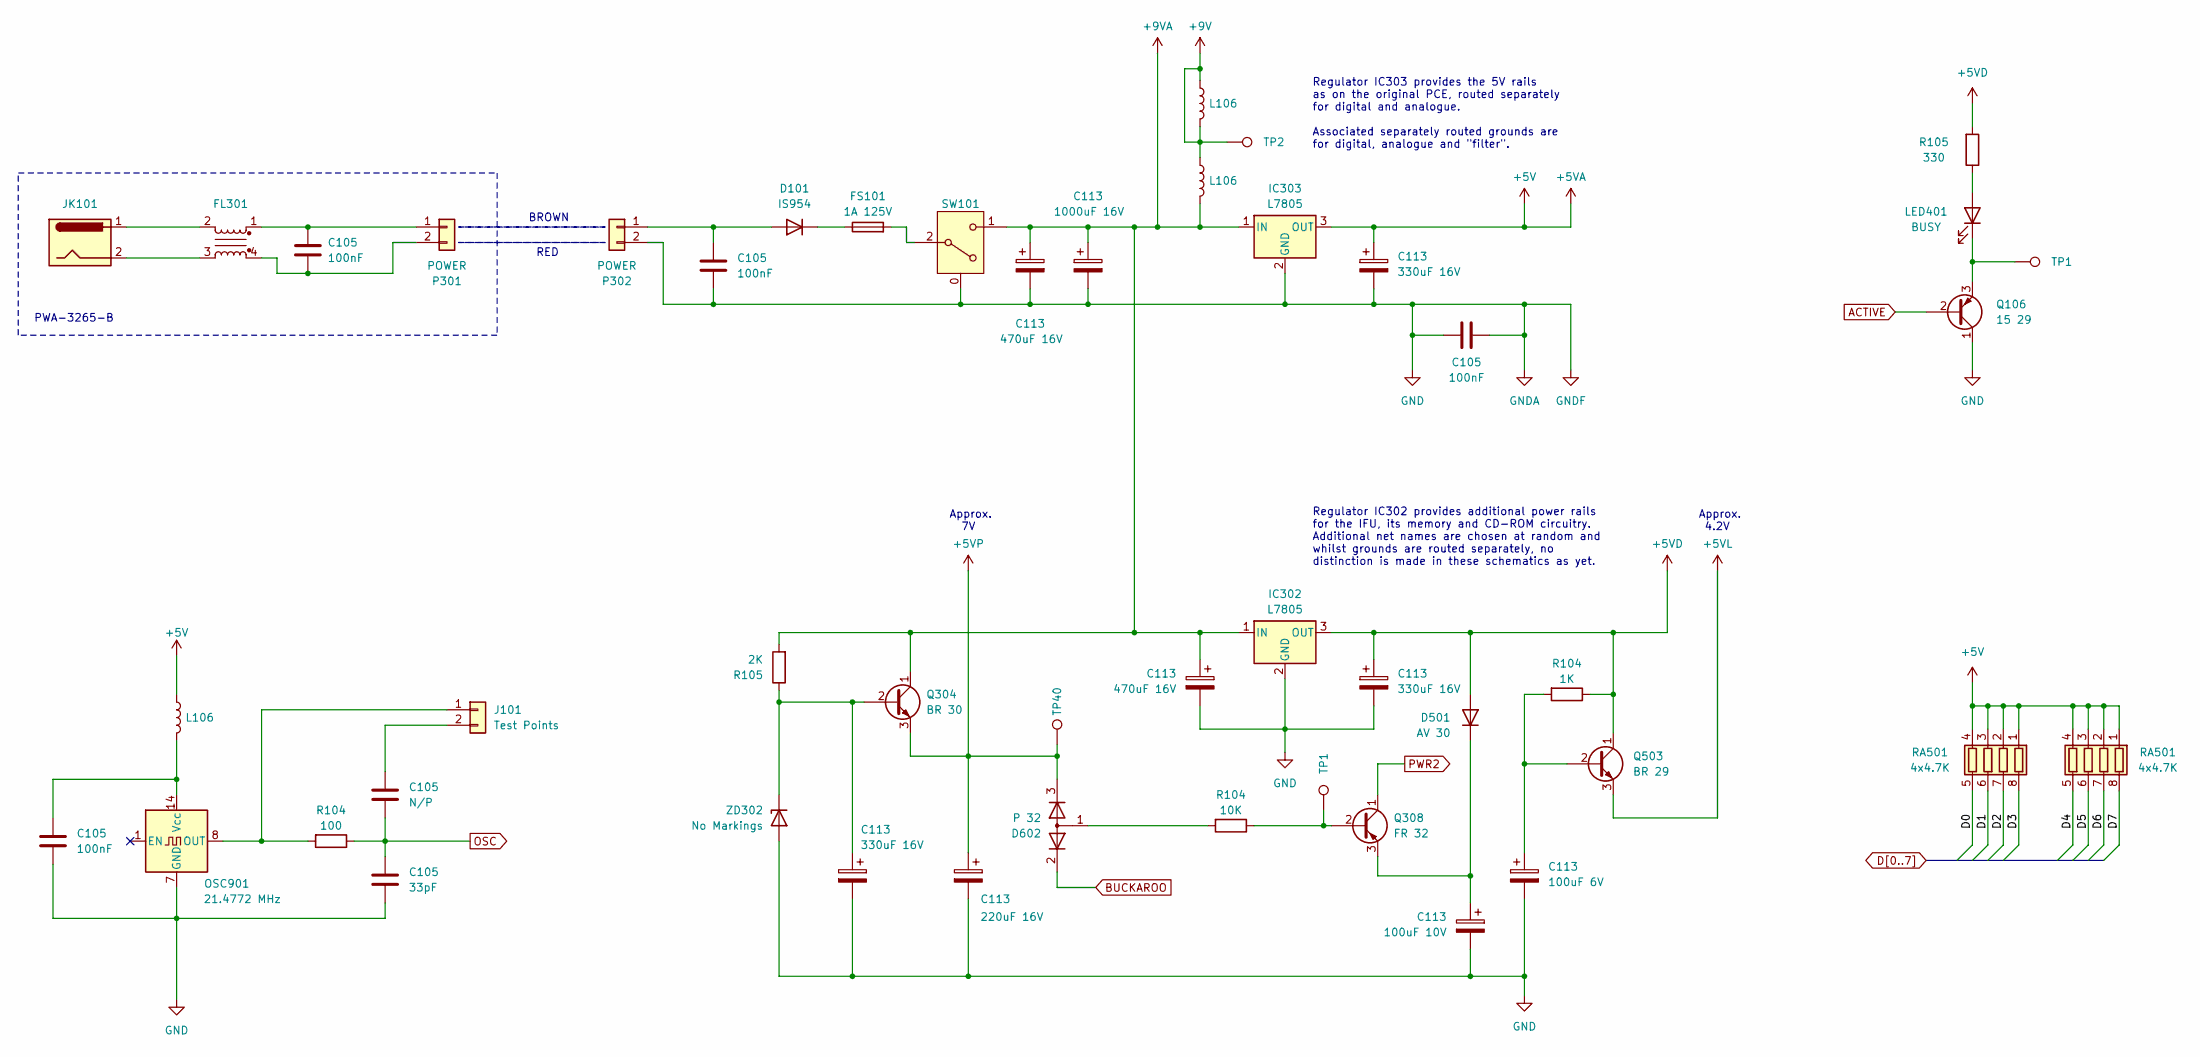
[picture p9: schematic power.kicad_sch]

Parts:
C105: 33pF; SMD_0805_Narrow_Long
C113: 470uF 16V; Elec_P5.00mm_D10.5mm
D101: IS954; Diode
D501: AV 30; Transistor_SMD
D602: P 32; Transistor_SMD
FL301: (no value)
FS101: 1A 125V; Fuse
IC302, IC303: L7805; 7805_Heatsink
J101: Test Points; 2xTest_Point
JK101: Barrel_Jack
L106: L-5.00mm
LED401: BUSY; Duo_LED
OSC901: 21.4772 MHz; Oscillator
P301, P302: POWER; Duo_Power
Q106: 15 29; Transistor_SMD
Q304: BR 30; Transistor_SMD
Q308: FR 32; Transistor_SMD
Q503: BR 29; Transistor_SMD
R104: 1K; SMD_0805_Narrow_Long
R105: 330; SMD_1210
RA501: 4x4.7K; R_Array_4x0603
SW101: SW_SPDT; SW101
TP1, TP2, TP40: Test_Point_1.5mm
ZD302: No Markings; Transistor_SMD

Connections:
+5V: C113.1, IC303.3 (OUT), L106.1, RA501.1 (R1.1), RA501.2 (R2.1), RA501.3 (R3.1), RA501.4 (R4.1)
+5VD: C113.1, D501.2 (A), IC302.3 (OUT), Q503.1 (C), R104.1, R105.2
+5VL: Q503.3 (E)
+5VP: C113.1, D602.3 (K), Q304.3 (E), TP40.1
+9V: L106.1, L106.2, TP2.1
+9VA: C113.1, IC302.1 (IN), IC303.1 (IN), L106.2, Q304.1 (C), R105.2, SW101.1 (A)
ACTIVE: Q106.2 (B)
BUCKAROO: D602.2 (K)
D0: RA501.5 (R4.2)
D1: RA501.6 (R3.2)
D2: RA501.7 (R2.2)
D3: RA501.8 (R1.2)
D4: RA501.5 (R4.2)
D5: RA501.6 (R3.2)
D6: RA501.7 (R2.2)
D7: RA501.8 (R1.2)
GND: C105.1, C105.2, C113.2, IC302.2 (GND), IC303.2 (GND), OSC901.7 (GND), P302.2, Q106.1 (C), SW101.0 (CASE), ZD302.2 (A)
unnamed: C105.1, D101.2 (A), FL301.1, J101.2, L106.2, OSC901.14 (Vcc), P301.1, P302.1
unnamed: C105.2, FL301.4, P301.2
unnamed: C113.1, D501.1 (K), Q304.2 (B), Q308.3 (E), Q503.2 (B), R104.2, R105.1, ZD302.1 (K)
unnamed: D101.1 (K), FS101.1
unnamed: D602.1 (A), R104.2
unnamed: FL301.2, JK101.1
unnamed: FL301.3, JK101.2
unnamed: FS101.2, SW101.2 (B)
unnamed: J101.1, OSC901.8 (OUT), R104.2
unnamed: LED401.1 (K), Q106.3 (E), TP1.1
unnamed: LED401.2 (A), R105.1
unnamed: Q308.2 (B), R104.1, TP1.1
OSC: C105.1, C105.2, R104.1
PWR2: Q308.1 (C)

Notes on the sheet:
RED
PWA-3265-B
Regulator IC302 provides additional power rails for the IFU, its memory and CD-ROM circuitry. Additional net names are chosen at random and whilst grounds are routed separately, no distinction is made in these schematics as yet.
Approx. 7V
Regulator IC303 provides the 5V rails as on the original PCE, routed separately for digital and analogue. Associated separately routed grounds are for digital, analogue and "filter".
BROWN
Approx. 4.2V
