Board-Folk/PC-Engine-Duo/vdc.kicad_sch

## KiCad design vdc.kicad_sch (2023-11-11)

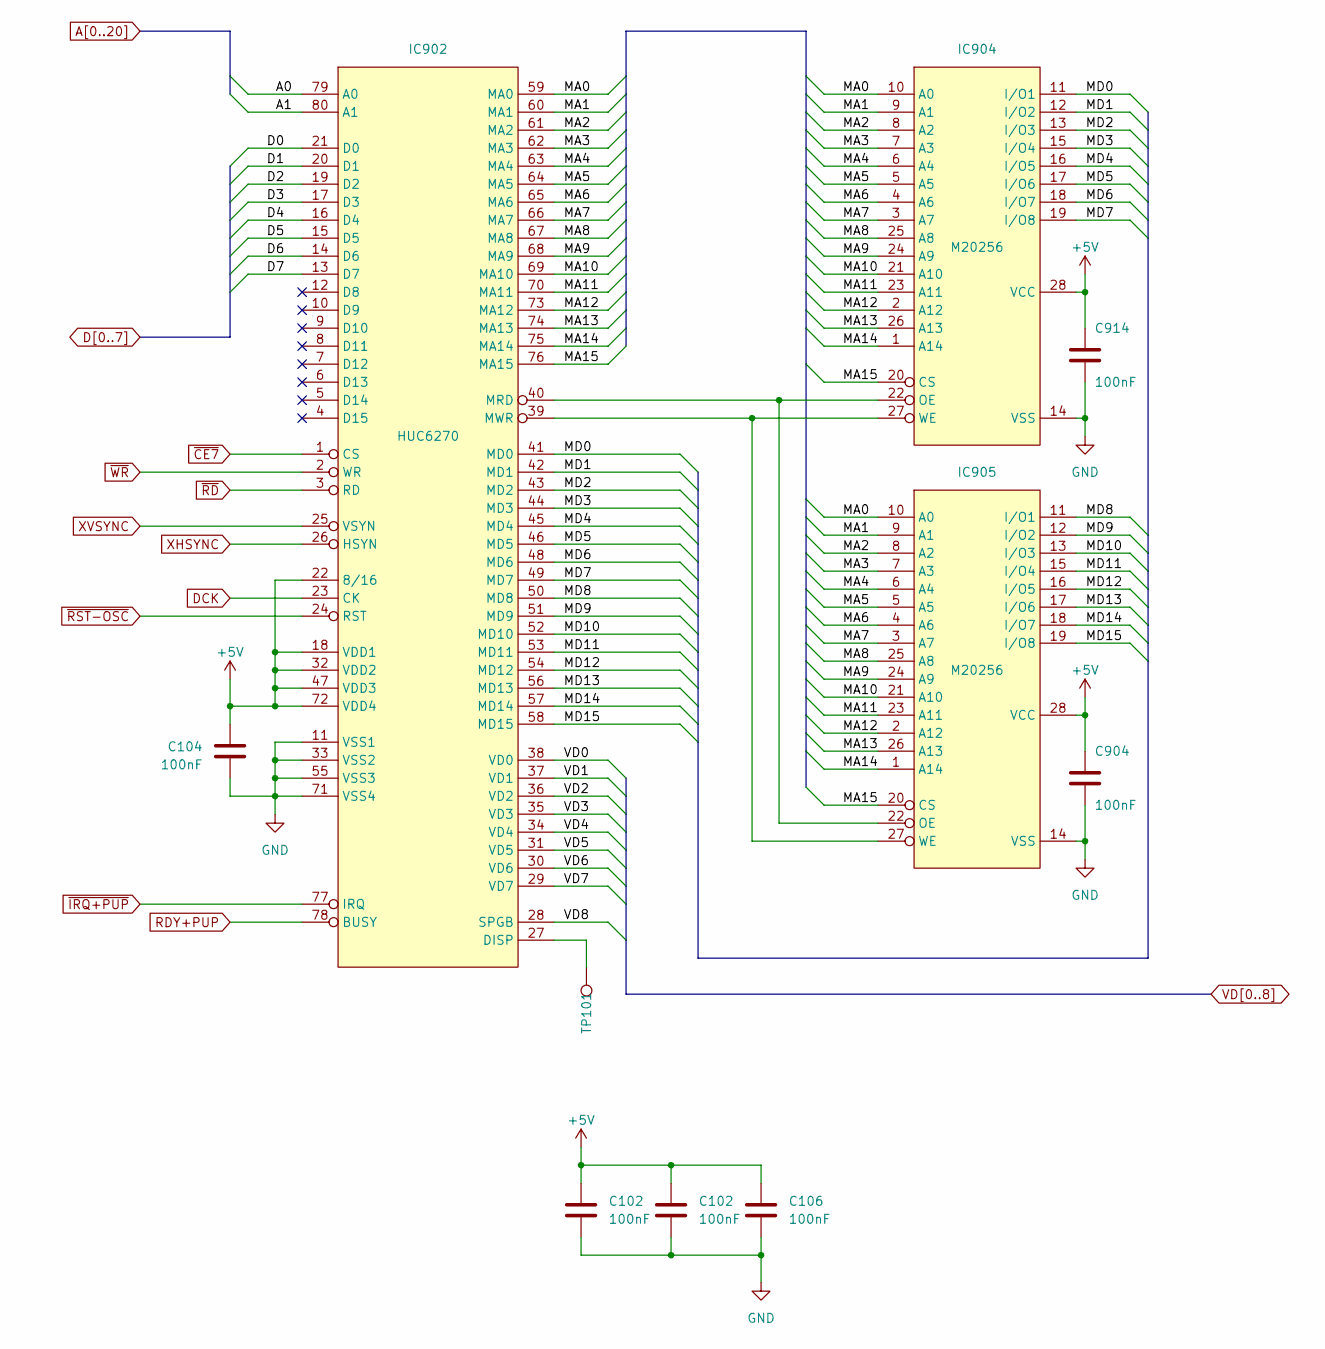
[picture p10: schematic vdc.kicad_sch]

Parts:
C102, C104, C106, C904, C914: 100nF; SMD_0805_Narrow
IC902: HUC6270; HUC62xx
IC904, IC905: M20256; HSRM20256LM
TP101: Test_Point_2mm_THT

Connections:
+5V: C102.1, C104.1, C106.1, C904.1, C914.1, IC902.18 (VDD1), IC902.22 (8/16), IC902.32 (VDD2), IC902.47 (VDD3), IC902.72 (VDD4), IC904.28 (VCC), IC905.28 (VCC)
A0: IC902.79 (A0)
A1: IC902.80 (A1)
D0: IC902.21 (D0)
D1: IC902.20 (D1)
D2: IC902.19 (D2)
D3: IC902.17 (D3)
D4: IC902.16 (D4)
D5: IC902.15 (D5)
D6: IC902.14 (D6)
D7: IC902.13 (D7)
DCK: IC902.23 (CK)
GND: C102.2, C104.2, C106.2, C904.2, C914.2, IC902.11 (VSS1), IC902.33 (VSS2), IC902.55 (VSS3), IC902.71 (VSS4), IC904.14 (VSS), IC905.14 (VSS)
MA0: IC902.59 (MA0), IC904.10 (A0), IC905.10 (A0)
MA1: IC902.60 (MA1), IC904.9 (A1), IC905.9 (A1)
MA2: IC902.61 (MA2), IC904.8 (A2), IC905.8 (A2)
MA3: IC902.62 (MA3), IC904.7 (A3), IC905.7 (A3)
MA4: IC902.63 (MA4), IC904.6 (A4), IC905.6 (A4)
MA5: IC902.64 (MA5), IC904.5 (A5), IC905.5 (A5)
MA6: IC902.65 (MA6), IC904.4 (A6), IC905.4 (A6)
MA7: IC902.66 (MA7), IC904.3 (A7), IC905.3 (A7)
MA8: IC902.67 (MA8), IC904.25 (A8), IC905.25 (A8)
MA9: IC902.68 (MA9), IC904.24 (A9), IC905.24 (A9)
MA10: IC902.69 (MA10), IC904.21 (A10), IC905.21 (A10)
MA11: IC902.70 (MA11), IC904.23 (A11), IC905.23 (A11)
MA12: IC902.73 (MA12), IC904.2 (A12), IC905.2 (A12)
MA13: IC902.74 (MA13), IC904.26 (A13), IC905.26 (A13)
MA14: IC902.75 (MA14), IC904.1 (A14), IC905.1 (A14)
MA15: IC902.76 (MA15), IC904.20 (CS), IC905.20 (CS)
MD0: IC902.41 (MD0), IC904.11 (I/O1)
MD1: IC902.42 (MD1), IC904.12 (I/O2)
MD2: IC902.43 (MD2), IC904.13 (I/O3)
MD3: IC902.44 (MD3), IC904.15 (I/O4)
MD4: IC902.45 (MD4), IC904.16 (I/O5)
MD5: IC902.46 (MD5), IC904.17 (I/O6)
MD6: IC902.48 (MD6), IC904.18 (I/O7)
MD7: IC902.49 (MD7), IC904.19 (I/O8)
MD8: IC902.50 (MD8), IC905.11 (I/O1)
MD9: IC902.51 (MD9), IC905.12 (I/O2)
MD10: IC902.52 (MD10), IC905.13 (I/O3)
MD11: IC902.53 (MD11), IC905.15 (I/O4)
MD12: IC902.54 (MD12), IC905.16 (I/O5)
MD13: IC902.56 (MD13), IC905.17 (I/O6)
MD14: IC902.57 (MD14), IC905.18 (I/O7)
MD15: IC902.58 (MD15), IC905.19 (I/O8)
unnamed: IC902.27 (DISP), TP101.1
unnamed: IC902.39 (MWR), IC904.27 (WE), IC905.27 (WE)
unnamed: IC902.40 (MRD), IC904.22 (OE), IC905.22 (OE)
RDY+PUP: IC902.78 (BUSY)
VD0: IC902.38 (VD0)
VD1: IC902.37 (VD1)
VD2: IC902.36 (VD2)
VD3: IC902.35 (VD3)
VD4: IC902.34 (VD4)
VD5: IC902.31 (VD5)
VD6: IC902.30 (VD6)
VD7: IC902.29 (VD7)
VD8: IC902.28 (SPGB)
XHSYNC: IC902.26 (HSYN)
XVSYNC: IC902.25 (VSYN)
~CE7: IC902.1 (CS)
~IRQ+PUP: IC902.77 (IRQ)
~RD: IC902.3 (RD)
~RST-OSC: IC902.24 (RST)
~WR: IC902.2 (WR)
