Board-Folk/PC-Engine-Duo/video.kicad_sch

## KiCad design video.kicad_sch (2023-11-11)

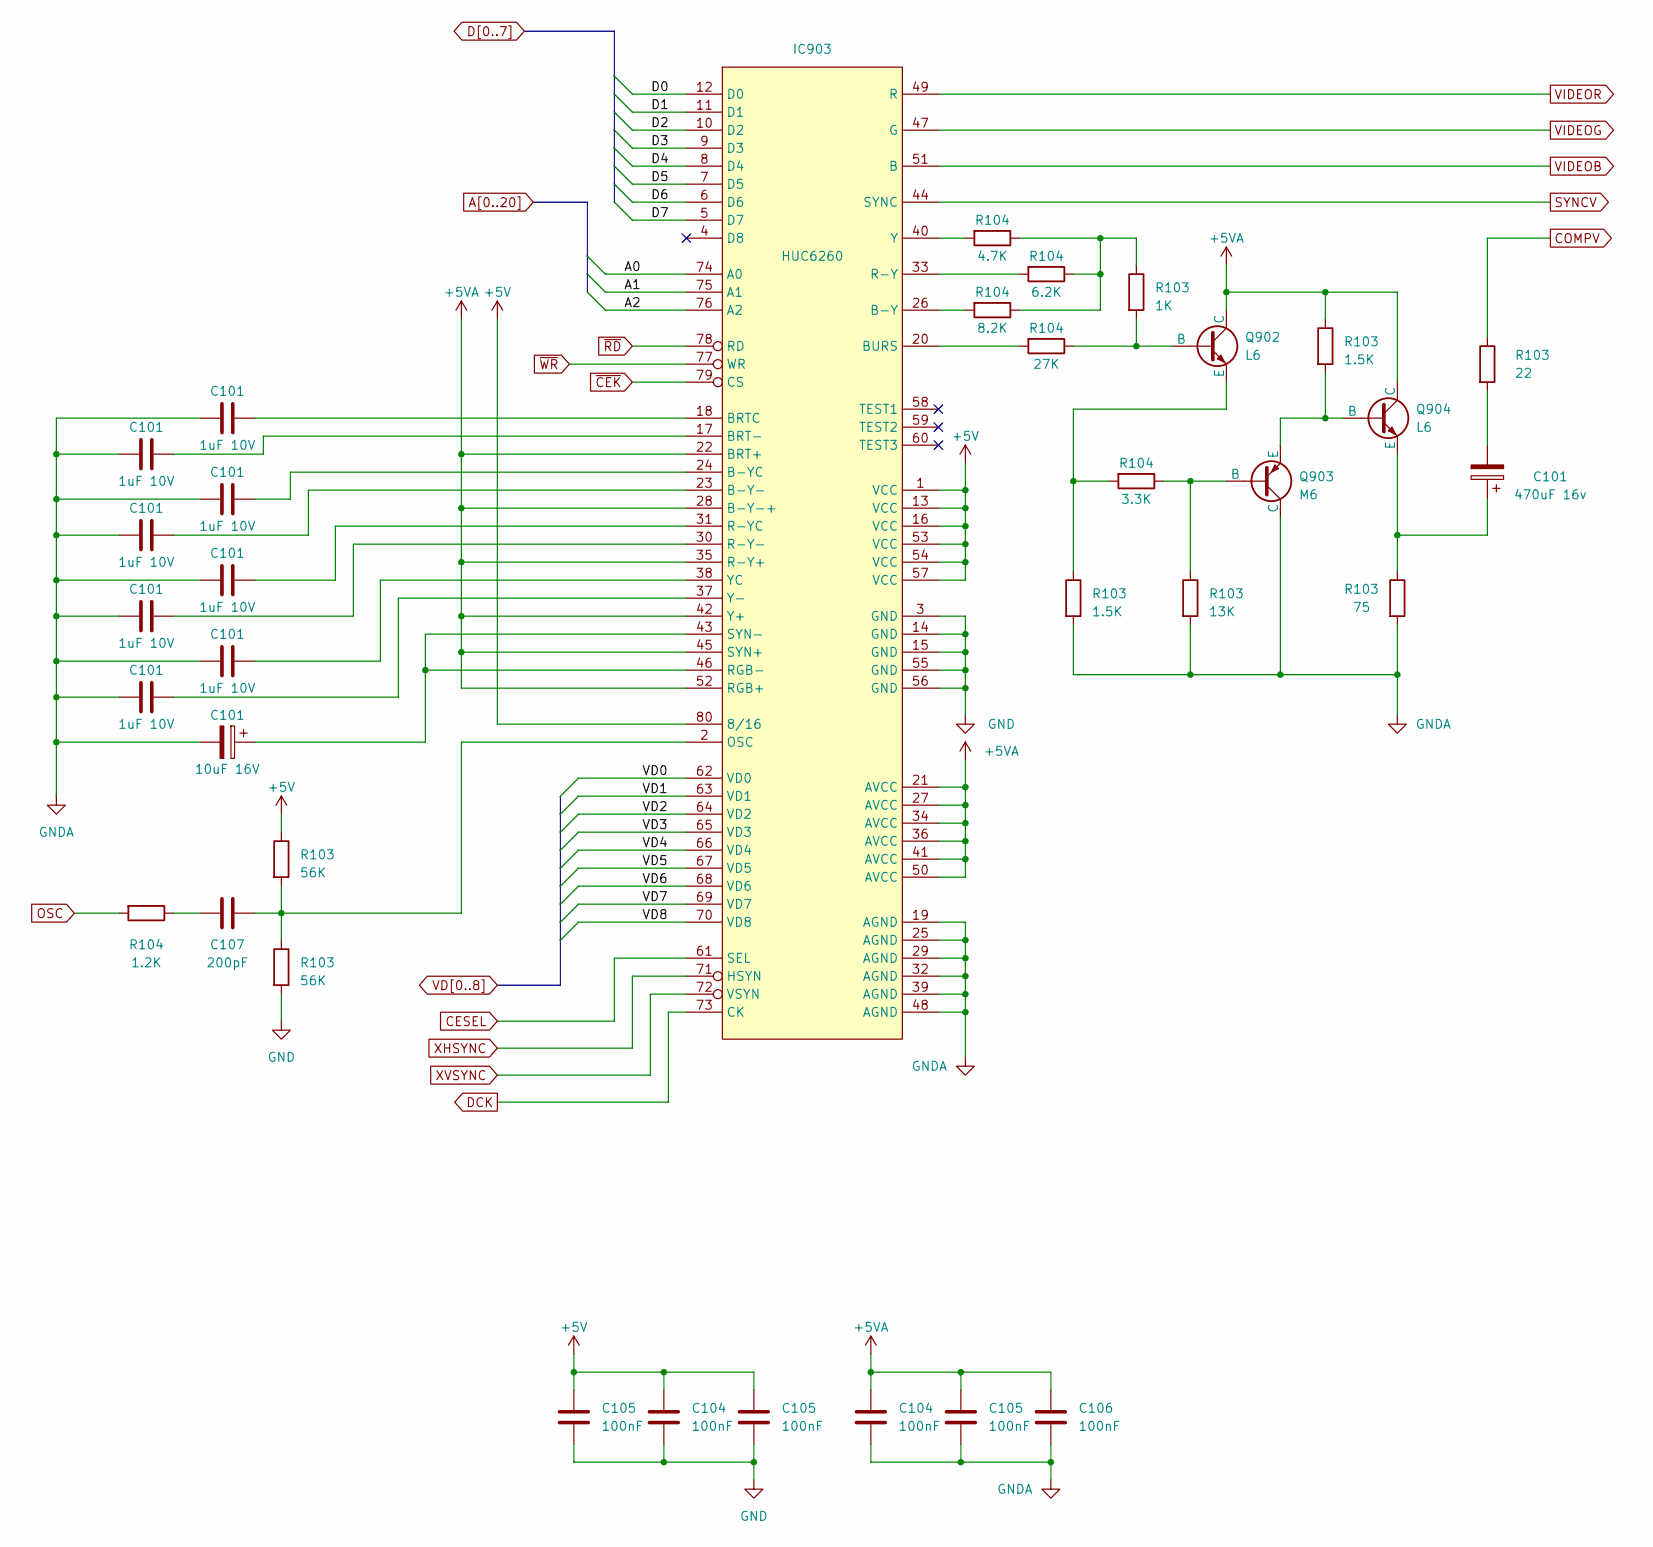
[picture p11: schematic video.kicad_sch]

Parts:
C101: 1uF 10V; SMD_0805_Narrow_Long
C104, C105, C106: 100nF; SMD_0805_Narrow
C107: 200pF; SMD_0805_Narrow
IC903: HUC6260; HUC62xx
Q902, Q904: L6; Transistor_SMD
Q903: M6; Transistor_SMD
R103: 56K; SMD_0805_Narrow
R104: 4.7K; SMD_0805_Narrow_Long

Connections:
+5V: C104.1, C105.1, IC903.1 (VCC), IC903.13 (VCC), IC903.16 (VCC), IC903.53 (VCC), IC903.54 (VCC), IC903.57 (VCC), IC903.80 (8/16), R103.1
+5VA: C104.1, C105.1, C106.1, IC903.21 (AVCC), IC903.22 (BRT+), IC903.27 (AVCC), IC903.28 (B-Y-+), IC903.34 (AVCC), IC903.35 (R-Y+), IC903.36 (AVCC), IC903.41 (AVCC), IC903.42 (Y+), IC903.45 (SYN+), IC903.50 (AVCC), IC903.52 (RGB+), Q902.1 (C), Q904.1 (C), R103.1
A0: IC903.74 (A0)
A1: IC903.75 (A1)
A2: IC903.76 (A2)
CESEL: IC903.61 (SEL)
COMPV: R103.1
D0: IC903.12 (D0)
D1: IC903.11 (D1)
D2: IC903.10 (D2)
D3: IC903.9 (D3)
D4: IC903.8 (D4)
D5: IC903.7 (D5)
D6: IC903.6 (D6)
D7: IC903.5 (D7)
DCK: IC903.73 (CK)
GND: C104.2, C105.2, IC903.3 (GND), IC903.14 (GND), IC903.15 (GND), IC903.55 (GND), IC903.56 (GND), R103.2
GNDA: C101.2, C104.2, C105.2, C106.2, IC903.19 (AGND), IC903.25 (AGND), IC903.29 (AGND), IC903.32 (AGND), IC903.39 (AGND), IC903.48 (AGND), Q903.1 (C), R103.2
unnamed: C101.1, IC903.17 (BRT-), IC903.18 (BRTC), IC903.23 (B-Y-), IC903.24 (B-YC), IC903.30 (R-Y-), IC903.31 (R-YC), IC903.37 (Y-), IC903.38 (YC), IC903.43 (SYN-), IC903.46 (RGB-), Q904.3 (E), R103.1
unnamed: C101.2, R103.2
unnamed: C107.1, R104.1
unnamed: C107.2, IC903.2 (OSC), R103.1, R103.2
unnamed: IC903.20 (BURS), R104.2
unnamed: IC903.26 (B-Y), R104.2
unnamed: IC903.33 (R-Y), R104.2
unnamed: IC903.40 (Y), R104.2
unnamed: Q902.2 (B), R103.2, R104.1
unnamed: Q902.3 (E), R103.1, R104.2
unnamed: Q903.2 (B), R103.1, R104.1
unnamed: Q903.3 (E), Q904.2 (B), R103.2
unnamed: R103.1, R104.1
OSC: R104.2
SYNCV: IC903.44 (SYNC)
VD0: IC903.62 (VD0)
VD1: IC903.63 (VD1)
VD2: IC903.64 (VD2)
VD3: IC903.65 (VD3)
VD4: IC903.66 (VD4)
VD5: IC903.67 (VD5)
VD6: IC903.68 (VD6)
VD7: IC903.69 (VD7)
VD8: IC903.70 (VD8)
VIDEOB: IC903.51 (B)
VIDEOG: IC903.47 (G)
VIDEOR: IC903.49 (R)
XHSYNC: IC903.71 (HSYN)
XVSYNC: IC903.72 (VSYN)
~CEK: IC903.79 (CS)
~RD: IC903.78 (RD)
~WR: IC903.77 (WR)
