Board-Folk/PC-Engine-Duo/(commit log)

2023-08-31 Rough layout/tracing using photos.
    [PCE-B_Cu.gbl, PCE-B_Mask.gbs, PCE-B_Paste.gbp, PCE-B_Silkscreen.gbo, PCE-Edge_Cuts.gm1, PCE-F_Cu.gtl, PCE-F_Mask.gts, PCE-F_Paste.gtp]
2023-10-14 Add proper scans, redo traces.
    [cd_rom_control.kicad_sch, cd_rom_mech.kicad_sch, connectors.kicad_sch, cpu.kicad_sch, interface.kicad_sch, interface_memory.kicad_sch, power.kicad_sch, vdc.kicad_sch]
2023-10-14 More tracing.
    [cd_rom_control.kicad_sch, cd_rom_mech.kicad_sch, connectors.kicad_sch, interface.kicad_sch, interface_memory.kicad_sch, power.kicad_sch]
2023-10-14 Yet more tracing.
    [cd_rom_control.kicad_sch, cd_rom_mech.kicad_sch, interface.kicad_sch, interface_memory.kicad_sch, power.kicad_sch]
2023-10-15 Power rails, etc.
    [cd_rom_control.kicad_sch, cd_rom_mech.kicad_sch, connectors.kicad_sch, interface.kicad_sch, power.kicad_sch]
2023-10-17 IC routing mostly complete, start adding passives.
    [cd_rom_control.kicad_sch, cd_rom_mech.kicad_sch, connectors.kicad_sch, cpu.kicad_sch, interface.kicad_sch, interface_memory.kicad_sch, power.kicad_sch, vdc.kicad_sch]
2023-10-23 Bunch of passives and what-not.
    [cd_rom_control.kicad_sch, cd_rom_mech.kicad_sch, cpu.kicad_sch, interface.kicad_sch, power.kicad_sch, video.kicad_sch]
2023-10-25 More passives, custom footprints, etc.
    [cd_rom_control.kicad_sch, cd_rom_mech.kicad_sch, connectors.kicad_sch, cpu.kicad_sch, interface.kicad_sch, interface_memory.kicad_sch, power.kicad_sch, video.kicad_sch]
2023-10-26 Top layer first draft.
    [cd_rom_control.kicad_sch, cd_rom_mech.kicad_sch, connectors.kicad_sch, cpu.kicad_sch, interface.kicad_sch, interface_memory.kicad_sch, power.kicad_sch, video.kicad_sch]
2023-10-27 More passives on back.
    [cd_rom_control.kicad_sch, cd_rom_mech.kicad_sch, connectors.kicad_sch, cpu.kicad_sch, interface.kicad_sch, power.kicad_sch]
2023-10-28 Yet more passives on back.
    [cd_rom_control.kicad_sch, cd_rom_mech.kicad_sch, connectors.kicad_sch, interface.kicad_sch, interface_memory.kicad_sch, power.kicad_sch]
2023-10-28 First draft complete.
    [cd_rom_control.kicad_sch, cd_rom_mech.kicad_sch, connectors.kicad_sch, interface.kicad_sch, power.kicad_sch, video.kicad_sch]
2023-10-28 Fix DRC errors.
    [cd_rom_control.kicad_sch, cd_rom_mech.kicad_sch, connectors.kicad_sch, cpu.kicad_sch, interface.kicad_sch, interface_memory.kicad_sch, power.kicad_sch, vdc.kicad_sch]
2023-10-29 General clean-up.
    [PCE-B_Cu.gbl, PCE-B_Mask.gbs, PCE-B_Paste.gbp, PCE-B_Silkscreen.gbo, PCE-Edge_Cuts.gm1, PCE-F_Cu.gtl, PCE-F_Mask.gts, PCE-F_Paste.gtp]
2023-10-29 Generate gerbers.
    [PCE-B_Cu.gbl, PCE-B_Mask.gbs, PCE-B_Paste.gbp, PCE-B_Silkscreen.gbo, PCE-Edge_Cuts.gm1, PCE-F_Cu.gtl, PCE-F_Mask.gts, PCE-F_Paste.gtp]
2023-10-30 Add resistor values to schematics.
    [cd_rom_control.kicad_sch, cd_rom_mech.kicad_sch, connectors.kicad_sch, cpu.kicad_sch, interface.kicad_sch, interface_memory.kicad_sch, power.kicad_sch, video.kicad_sch]
2023-10-30 Schematic clean-up.
    [cd_rom_control.kicad_sch, cd_rom_mech.kicad_sch, interface.kicad_sch, interface_memory.kicad_sch]
2023-10-31 Intermediate commit after renaming some nets.
    [cd_rom_control.kicad_sch, connectors.kicad_sch, interface.kicad_sch, interface_memory.kicad_sch]
2023-10-31 "Complete" clean-up of CD ROM control schematic.
    [cd_rom_control.kicad_sch]
2023-10-31 Schematic clean-up (IFU ASIC and other stuff).
    [cd_rom_control.kicad_sch, cd_rom_mech.kicad_sch, connectors.kicad_sch, interface.kicad_sch, interface_memory.kicad_sch, power.kicad_sch]
2023-11-01 Tidy up IFU audio schematic.
    [cd_rom_mech.kicad_sch, interface.kicad_sch]
2023-11-01 More clean-up stuff.
    [cd_rom_mech.kicad_sch, cpu.kicad_sch, interface.kicad_sch]
2023-11-01 First stage basic clean-up complete.
    [cd_rom_mech.kicad_sch]
2023-11-01 Add schematic notes.
    [PCE.kicad_sch, cd_rom_control.kicad_sch, cd_rom_mech.kicad_sch, connectors.kicad_sch, cpu.kicad_sch, interface.kicad_sch, interface_memory.kicad_sch, power.kicad_sch]
2023-11-01 Neaten up audio jack ground pin.
2023-11-02 Add known capacitor values to schematic. PCB changes: - Corrected C332 -> C322 - Corrected C929 -> C962 - Added missing C166 (extra decoupling for IC105)
    [cd_rom_control.kicad_sch, cd_rom_mech.kicad_sch, cpu.kicad_sch, interface.kicad_sch, interface_memory.kicad_sch, power.kicad_sch, vdc.kicad_sch, video.kicad_sch]
2023-11-02 Tidy references/values on schematics.
    [cd_rom_control.kicad_sch, cd_rom_mech.kicad_sch, connectors.kicad_sch, cpu.kicad_sch, interface.kicad_sch, interface_memory.kicad_sch, power.kicad_sch, video.kicad_sch]
2023-11-02 Add more capacitor values, rearrange some schematics.
    [cd_rom_control.kicad_sch, cd_rom_mech.kicad_sch, connectors.kicad_sch, cpu.kicad_sch, interface.kicad_sch, power.kicad_sch]
2023-11-02 Add markings for SMD Ds and Qs.
    [cd_rom_control.kicad_sch, cd_rom_mech.kicad_sch, connectors.kicad_sch, cpu.kicad_sch, interface.kicad_sch, interface_memory.kicad_sch, power.kicad_sch, video.kicad_sch]
2023-11-03 More schematic clean-up/annotation.
    [PCE-B_Cu.gbl, PCE-B_Mask.gbs, PCE-B_Paste.gbp, PCE-B_Silkscreen.gbo, PCE-Edge_Cuts.gm1, PCE-F_Cu.gtl, PCE-F_Mask.gts, PCE-F_Paste.gtp]
2023-11-04 Correct some values/references.
    [cd_rom_control.kicad_sch, cd_rom_mech.kicad_sch, interface.kicad_sch, interface_memory.kicad_sch, video.kicad_sch]
2023-11-06 Minor footprint and silkscreen changes/corrections.
    [PCE.kicad_sch, cd_rom_control.kicad_sch, cd_rom_mech.kicad_sch, connectors.kicad_sch, cpu.kicad_sch, interface.kicad_sch, interface_memory.kicad_sch, power.kicad_sch]
2023-11-08 Minor schematic/silkscreen changes.
    [cd_rom_control.kicad_sch, cd_rom_mech.kicad_sch, connectors.kicad_sch, cpu.kicad_sch, interface.kicad_sch, interface_memory.kicad_sch, power.kicad_sch, video.kicad_sch]
2023-11-08 Refresh Gerbers and iBOM.
    [PCE-B_Cu.gbl, PCE-B_Mask.gbs, PCE-B_Paste.gbp, PCE-B_Silkscreen.gbo, PCE-Edge_Cuts.gm1, PCE-F_Cu.gtl, PCE-F_Mask.gts, PCE-F_Paste.gtp]
2023-11-09 Add PCLK label, flip silkscreen text for CXD1167Q.
    [cd_rom_control.kicad_sch, cd_rom_mech.kicad_sch]
2023-11-10 Prep revision
    [PCE-B_Cu.gbl, PCE-B_Mask.gbs, PCE-B_Paste.gbp, PCE-B_Silkscreen.gbo, PCE-Edge_Cuts.gm1, PCE-F_Cu.gtl, PCE-F_Mask.gts, PCE-F_Paste.gtp]
2023-11-11 BOM corrections, cosmetic PCB updates.
    [PCE-B_Cu.gbl, PCE-B_Mask.gbs, PCE-B_Paste.gbp, PCE-B_Silkscreen.gbo, PCE-Edge_Cuts.gm1, PCE-F_Cu.gtl, PCE-F_Mask.gts, PCE-F_Paste.gtp]
2023-11-11 Update PCB info in README.
2023-11-13 Correct typos in schematics.
    [cd_rom_mech.kicad_sch, power.kicad_sch]
2023-11-13 Add (excluded) HuCard slot for Turbo Duo to schematics.
    [connectors.kicad_sch]
